KaliAssistant/Lichee-Jack-pcb/doc/3D-BTM.png

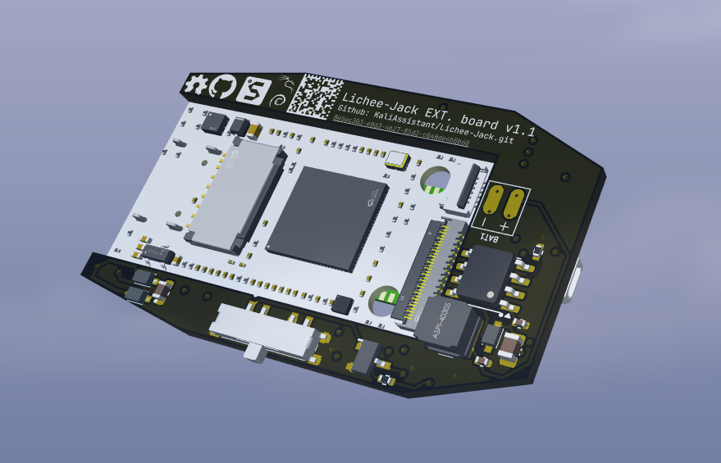
doc/3D-BTM.png
