KaliAssistant/Lichee-Jack-pcb/doc/3D-TOP.png

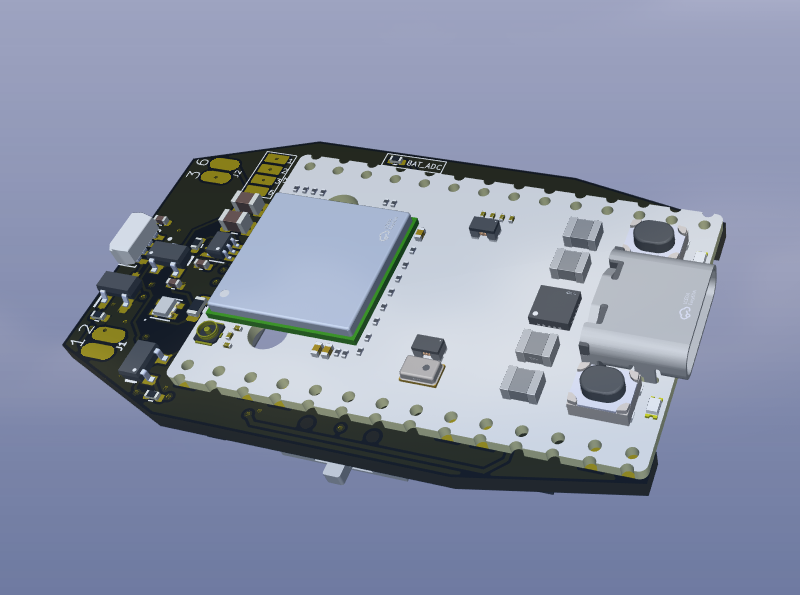
doc/3D-TOP.png
