KaliAssistant/Lichee-Jack-pcb/doc/FPC.jpg

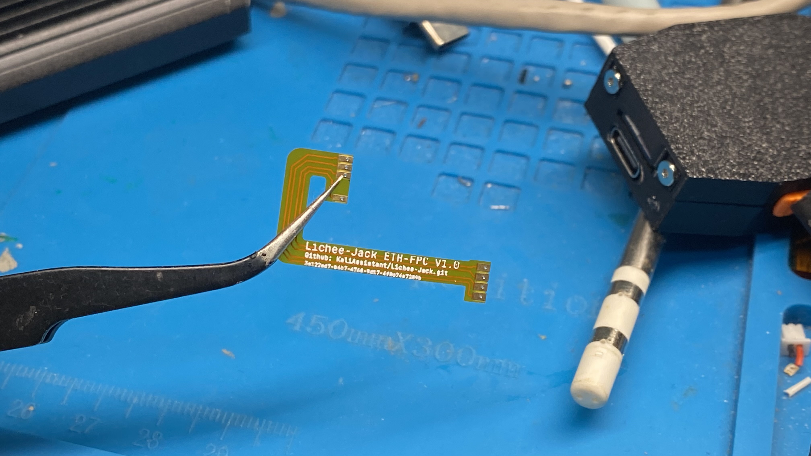
doc/FPC.jpg
