KaliAssistant/Lichee-Jack-pcb/doc/FPC_EDA.png

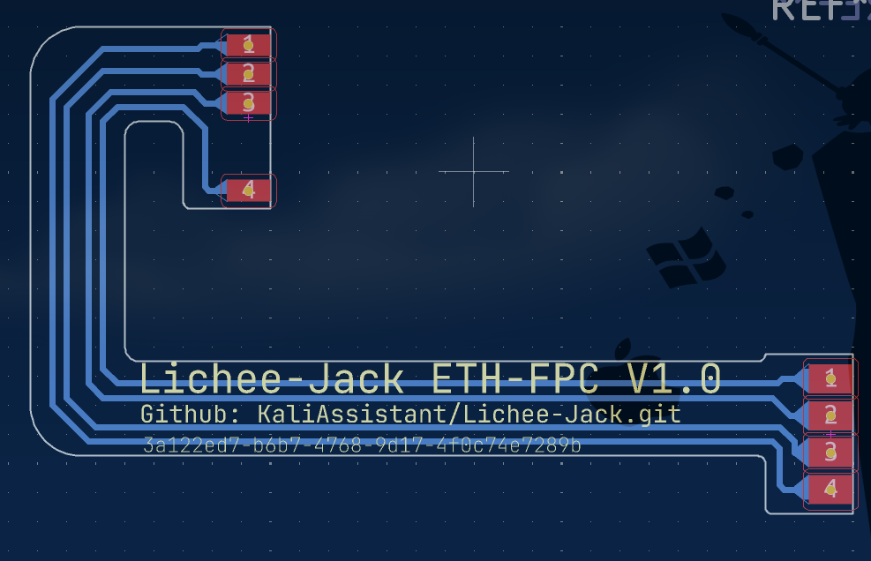
doc/FPC_EDA.png
