KaliAssistant/Lichee-Jack-pcb/doc/stackforfpcboard-3dview.png

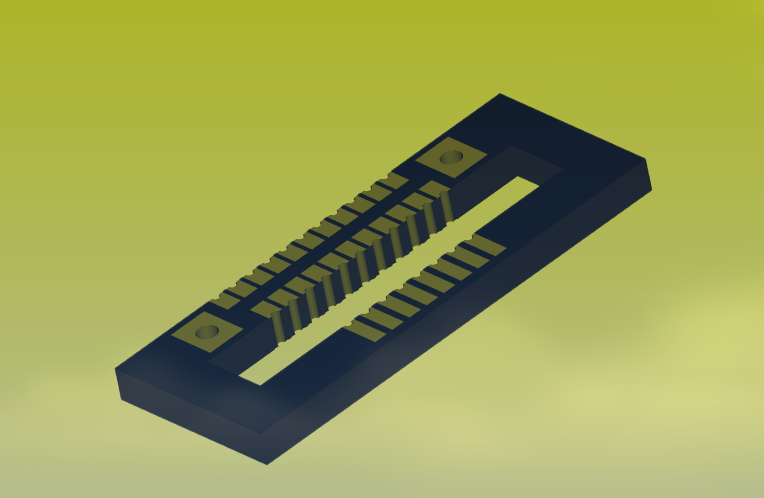
doc/stackforfpcboard-3dview.png
