KaliAssistant/Lichee-Jack-pcb/doc/stackforfpcboard-freecad.png

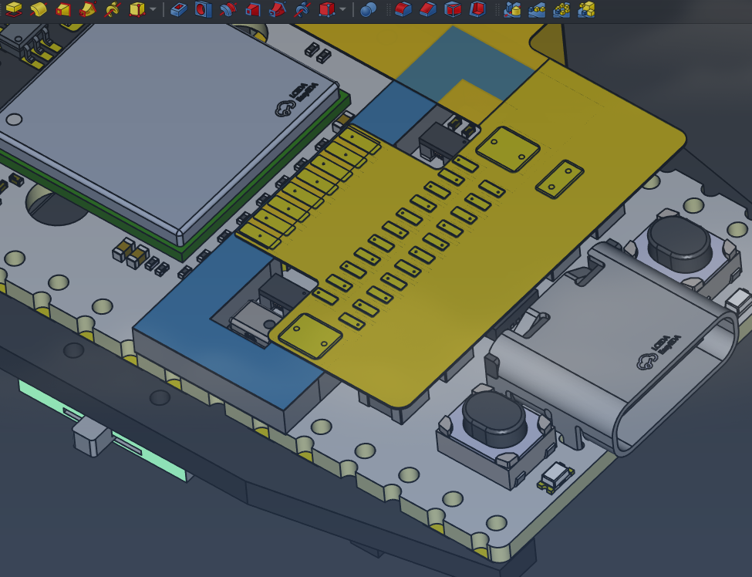
doc/stackforfpcboard-freecad.png
