KaliAssistant/Lichee-Jack-pcb/3dmodules/LED0603-RD-1.step

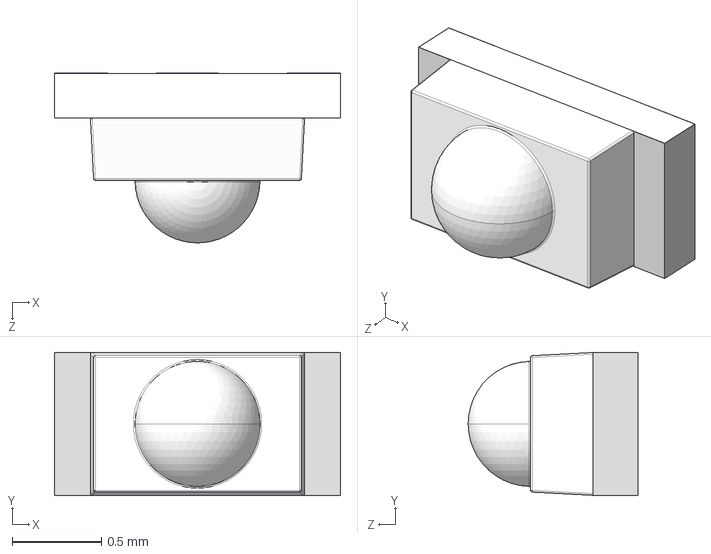
[picture p22: CAD file, 2026-01-12]
3dmodules/LED0603-RD-1.step
1.60 x 0.801 x 0.951 mm
