KaliAssistant/Lichee-Jack-pcb/3dmodules/SOT-23-5_L3.0-W1.6-P0.95-LS2.8-BR.step

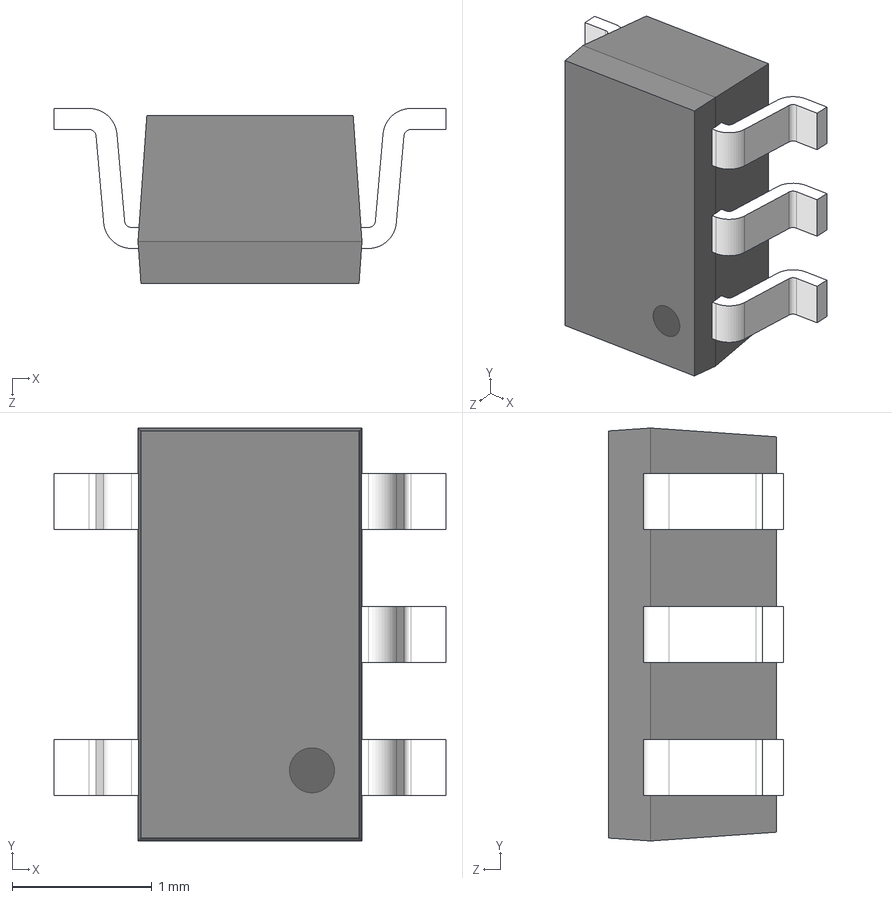
[picture p23: CAD file, 2026-01-11]
3dmodules/SOT-23-5_L3.0-W1.6-P0.95-LS2.8-BR.step
2.80 x 2.95 x 1.25 mm
