KaliAssistant/Lichee-Jack-pcb/3dmodules/LED0603_Inf.step

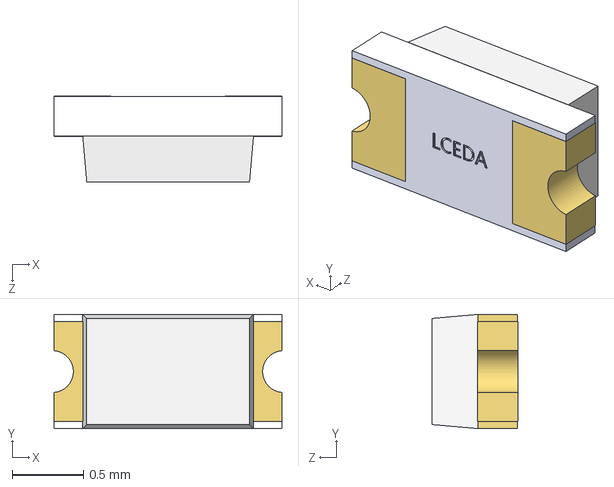
[picture p24: CAD file, 2026-01-11]
3dmodules/LED0603_Inf.step
1.60 x 0.802 x 0.601 mm
