KaliAssistant/Lichee-Jack-pcb/3dmodules/USB-C_SMD-TYPE-C-31-M-12.step

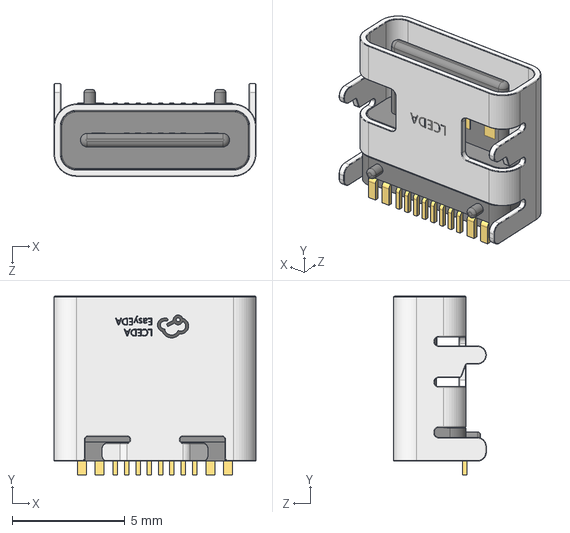
[picture p25: CAD file, 2026-01-11]
3dmodules/USB-C_SMD-TYPE-C-31-M-12.step
8.94 x 7.90 x 4.10 mm
