KaliAssistant/Lichee-Jack-pcb/3dmodules/LED0603-RD_GREEN.step

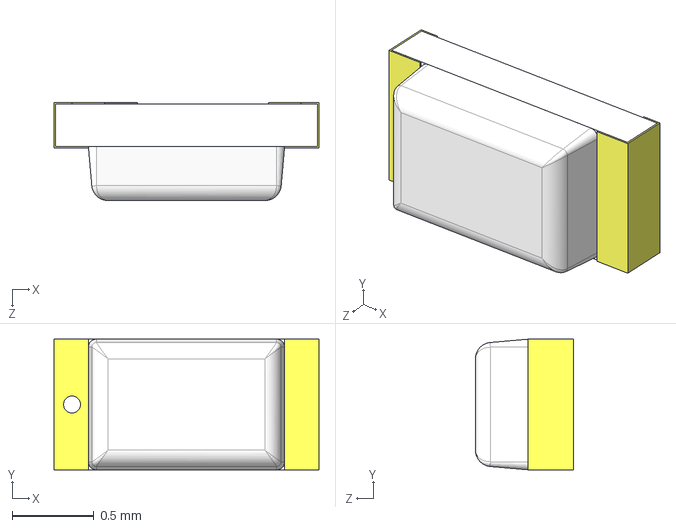
[picture p26: CAD file, 2026-01-11]
3dmodules/LED0603-RD_GREEN.step
1.62 x 0.8 x 0.6 mm
