KaliAssistant/Lichee-Jack-pcb/3dmodules/WQFN-28_L5.0-W5.0-P0.50-BL-EP3.2.step

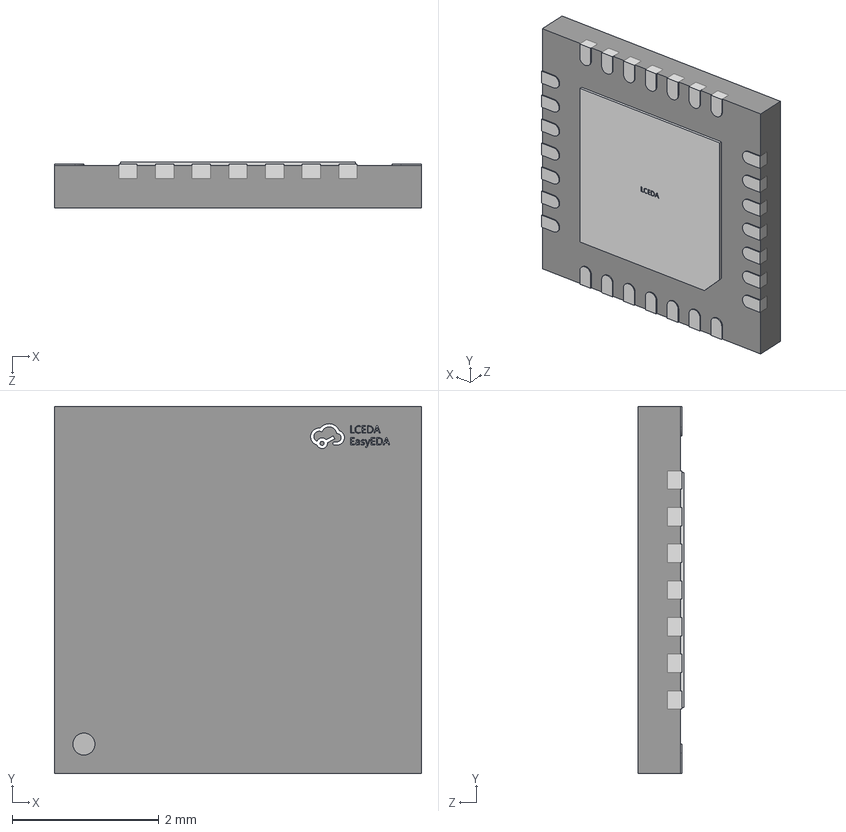
[picture p27: CAD file, 2026-01-11]
3dmodules/WQFN-28_L5.0-W5.0-P0.50-BL-EP3.2.step
5.00 x 5.00 x 0.631 mm
