KaliAssistant/Lichee-Jack-pcb/3dmodules/C1210_L3.2-W2.5-H2.5.step

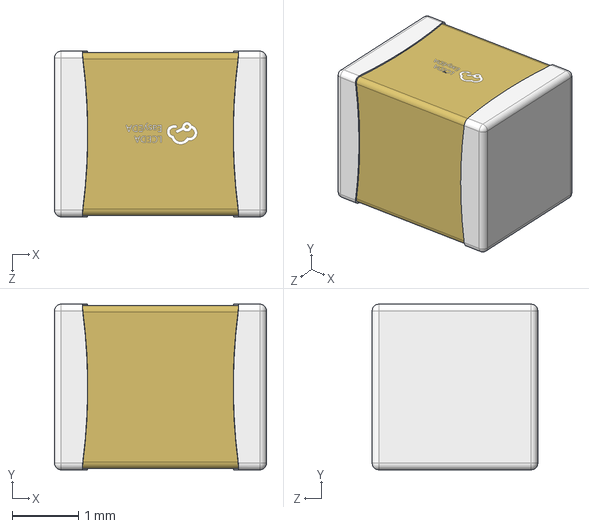
[picture p28: CAD file, 2026-01-11]
3dmodules/C1210_L3.2-W2.5-H2.5.step
3.20 x 2.50 x 2.50 mm
