KaliAssistant/Lichee-Jack-pcb/3dmodules/CRYSTAL-SMD_4P-L2.0-W1.6-BL.step

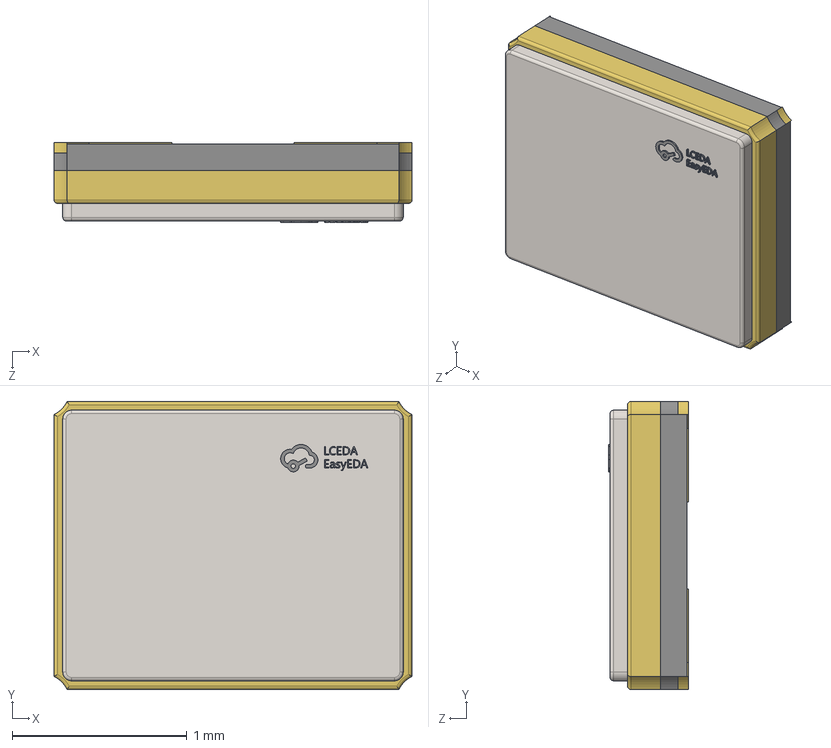
[picture p29: CAD file, 2026-01-11]
3dmodules/CRYSTAL-SMD_4P-L2.0-W1.6-BL.step
2.05 x 1.65 x 0.46 mm
