KaliAssistant/Lichee-Jack-pcb/3dmodules/X1SON-2_L1.0-W0.6-H0.4-P0.65.step

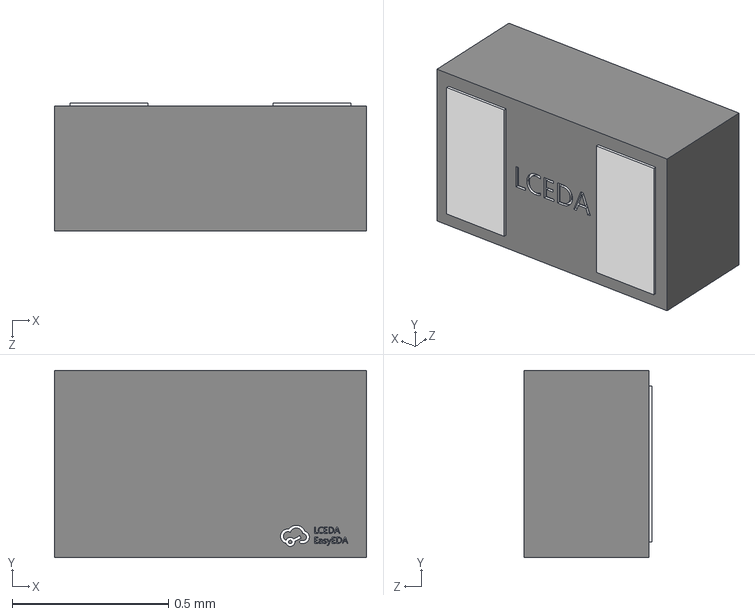
[picture p30: CAD file, 2026-01-11]
3dmodules/X1SON-2_L1.0-W0.6-H0.4-P0.65.step
1.00 x 0.6 x 0.411 mm
