KaliAssistant/Lichee-Jack-pcb/3dmodules/QFN-24_L4.0-W4.0-H0.9-P0.50.step

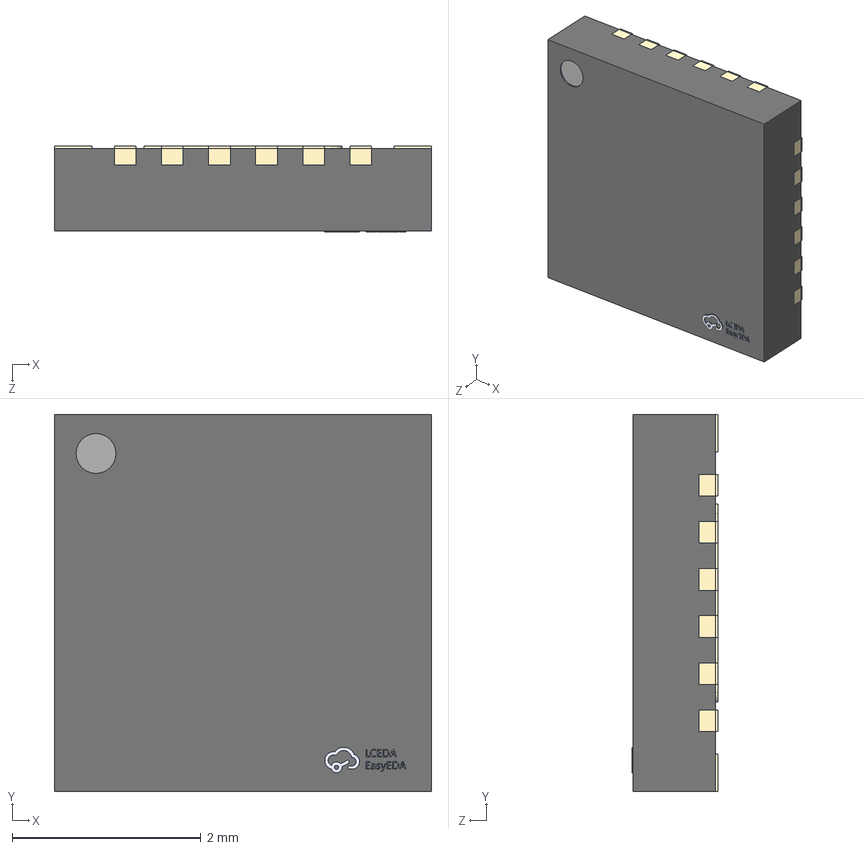
[picture p31: CAD file, 2026-01-11]
3dmodules/QFN-24_L4.0-W4.0-H0.9-P0.50.step
4.00 x 4.00 x 0.91 mm
