KaliAssistant/Lichee-Jack-pcb/3dmodules/wio-sx1262-N-no-shield.step

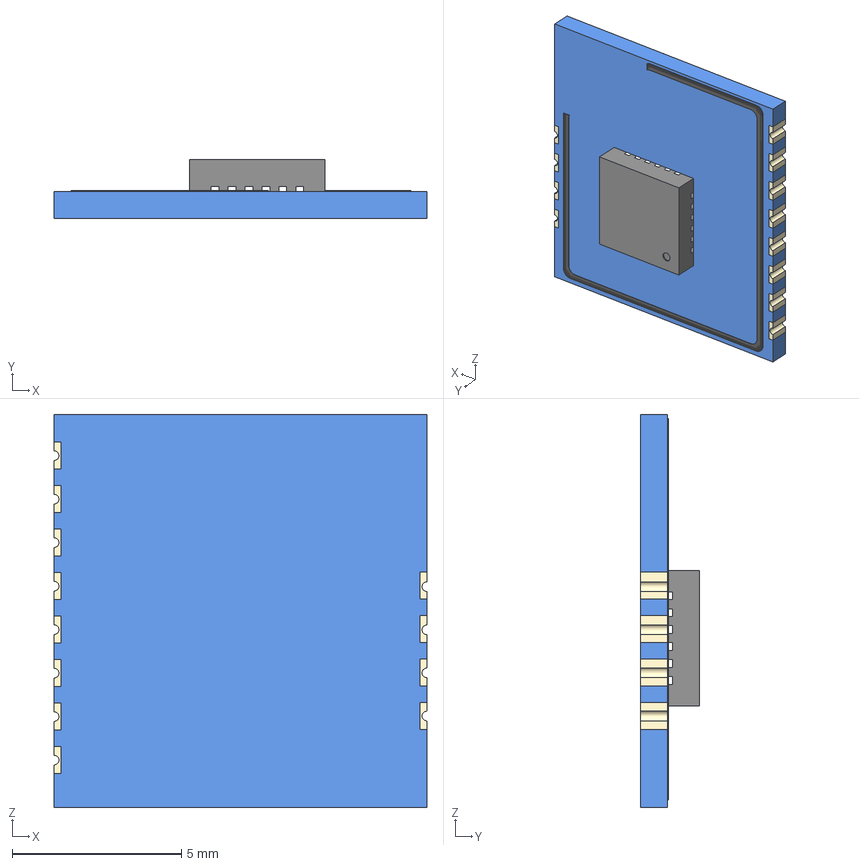
[picture p32: CAD file, 2025-12-26]
3dmodules/wio-sx1262-N-no-shield.step
11.0 x 1.75 x 11.6 mm
STM32F413CHU6
STM32F413CHU007
STM32F413CHU008
STM32F413CHU009
STM32F413CHU010
STM32F413CHU011
STM32F413CHU012
STM32F413CHU013
STM32F413CHU014
STM32F413CHU015
STM32F413CHU016
STM32F413CHU017
STM32F413CHU018
STM32F413CHU019
STM32F413CHU020
STM32F413CHU021
STM32F413CHU022
STM32F413CHU023
STM32F413CHU024
STM32F413CHU025
STM32F413CHU026
STM32F413CHU027
STM32F413CHU028
STM32F413CHU029
STM32F413CHU030
STM32F413CHU031
Mesh_Mesh_head_geo.001_lambert2SG.001
