KaliAssistant/Lichee-Jack-pcb/3dmodules/USB-A-TH_USB-05.step

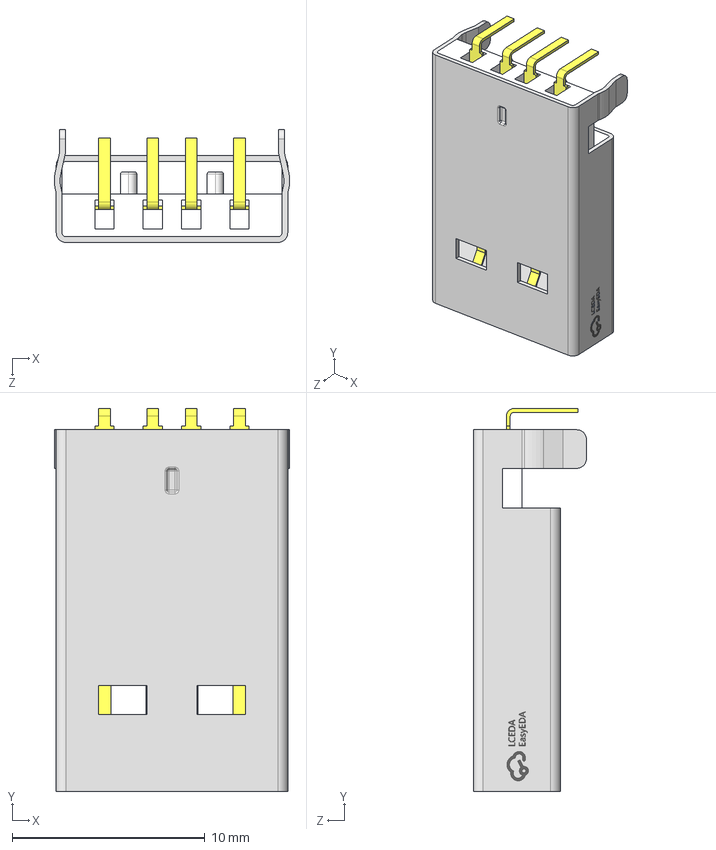
[picture p33: CAD file, 2025-12-26]
3dmodules/USB-A-TH_USB-05.step
12.2 x 19.9 x 5.85 mm
