KaliAssistant/Lichee-Jack-pcb/3dmodules/FFC-SMD_8P-P0.50_F0504-H-08-10G-R.step

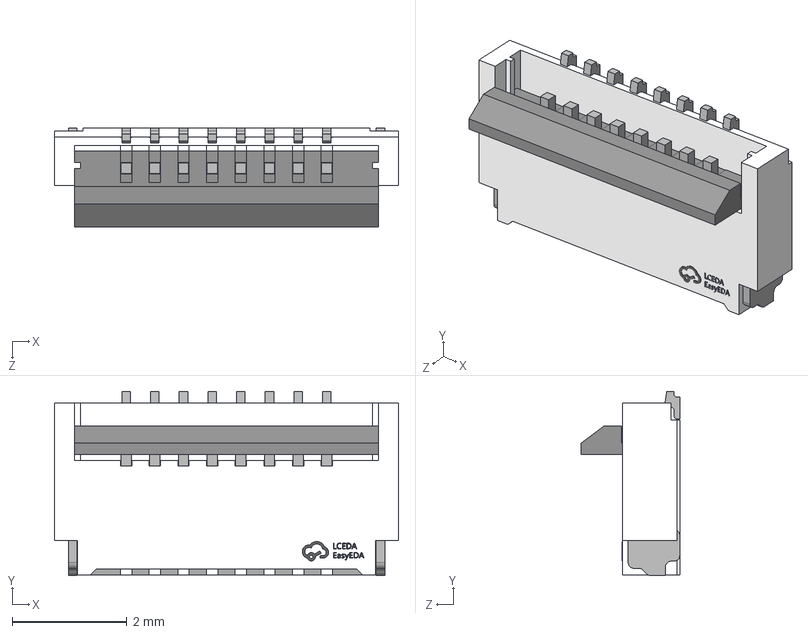
[picture p34: CAD file, 2025-12-26]
3dmodules/FFC-SMD_8P-P0.50_F0504-H-08-10G-R.step
6.00 x 3.21 x 1.72 mm
