KaliAssistant/Lichee-Jack-pcb/3dmodules/ABM8G-24.000MHZ-18-D2Y-T.step

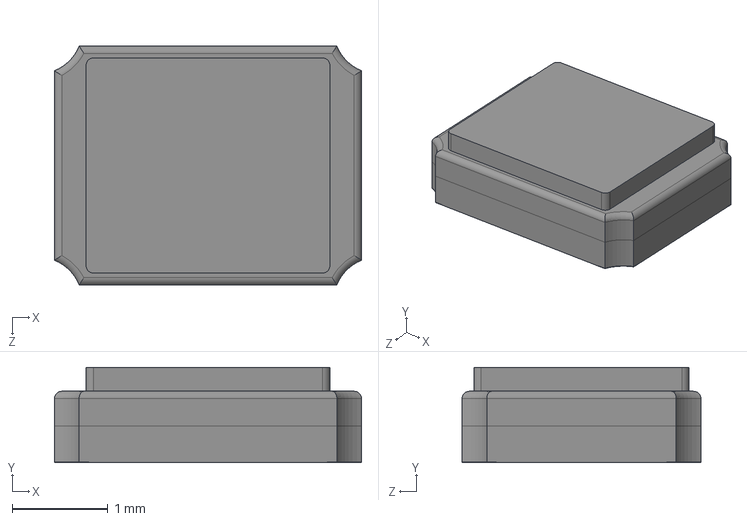
[picture p35: CAD file, 2025-12-26]
3dmodules/ABM8G-24.000MHZ-18-D2Y-T.step
3.20 x 0.991 x 2.49 mm
