KaliAssistant/Lichee-Jack-pcb/3dmodules/LICHEE-JACK_HEADER_BOARD.step

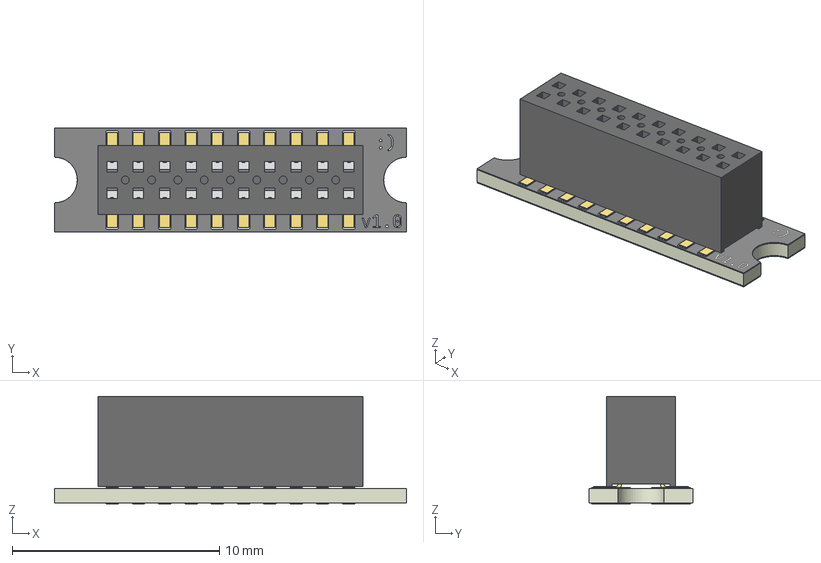
[picture p36: CAD file, 2025-12-26]
3dmodules/LICHEE-JACK_HEADER_BOARD.step
17.0 x 5.00 x 5.24 mm
FLE-110-01-DV_socket
C-96-01-10-DV
LICHEE-JACK_HEADER_BOARD_pad
LICHEE-JACK_HEADER_BOARD_silkscreen x 2
LICHEE-JACK_HEADER_BOARD_soldermask x 2
LICHEE-JACK_HEADER_BOARD_PCB
