KaliAssistant/Lichee-Jack-pcb/3dmodules/USB-C-SMD_C561769.step

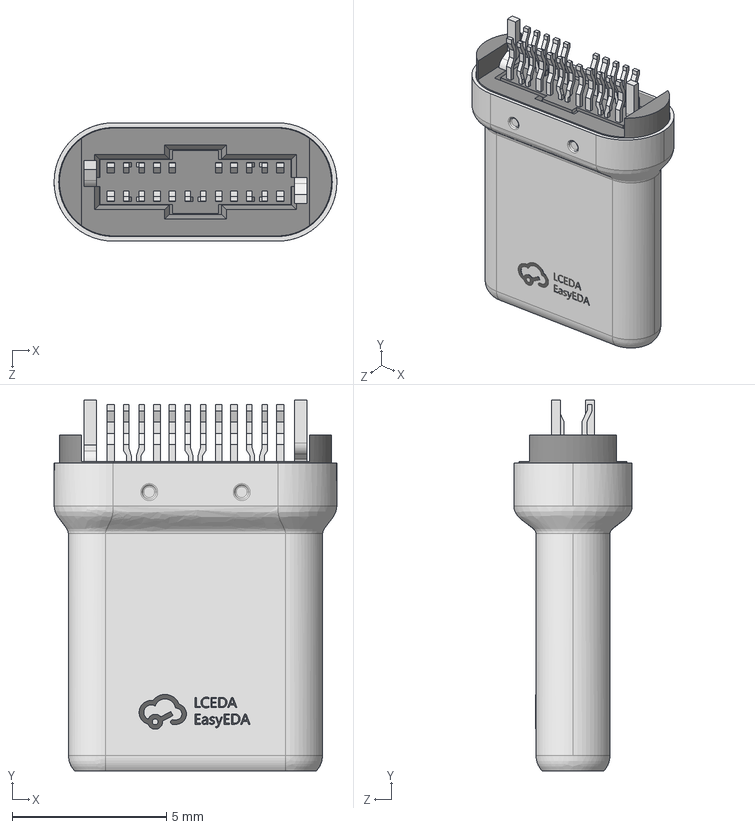
[picture p37: CAD file, 2025-12-26]
3dmodules/USB-C-SMD_C561769.step
9.18 x 12.0 x 3.84 mm
