KaliAssistant/Lichee-Jack-pcb/3dmodules/NFP114H_TFTLCD.step

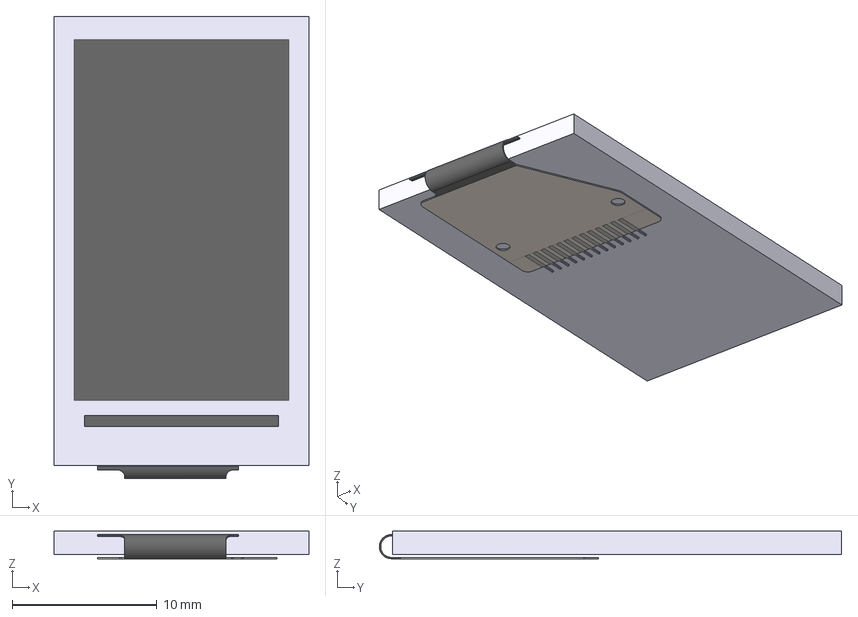
[picture p38: CAD file, 2025-12-26]
3dmodules/NFP114H_TFTLCD.step
17.6 x 31.9 x 1.90 mm
