KaliAssistant/Lichee-Jack-pcb/3dmodules/FLE-110-01-G-DV-K-TR.step

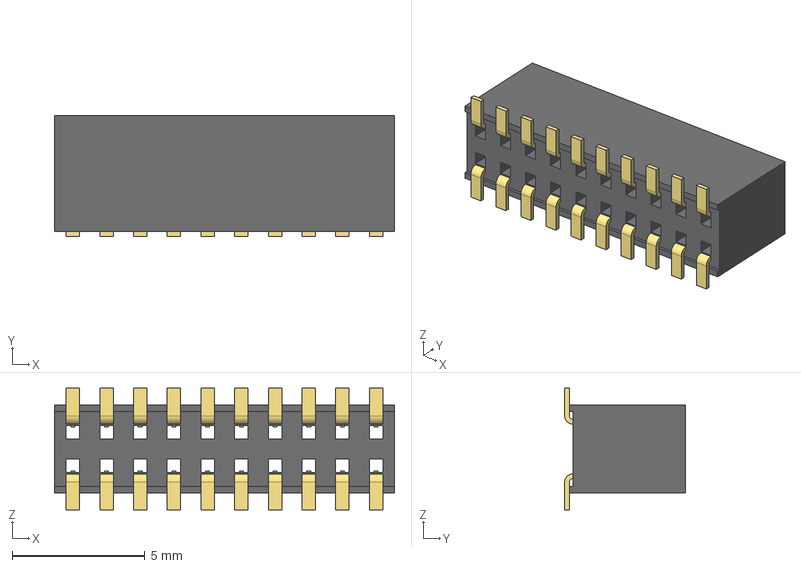
[picture p39: CAD file, 2025-12-26]
3dmodules/FLE-110-01-G-DV-K-TR.step
12.8 x 4.55 x 4.59 mm
FLE-110-01-DV_socket
C-96-01-10-DV
