KaliAssistant/Lichee-Jack-pcb/3dmodules/FFC-SMD_6P-P0.50_F0504-H-06-10G-R.step

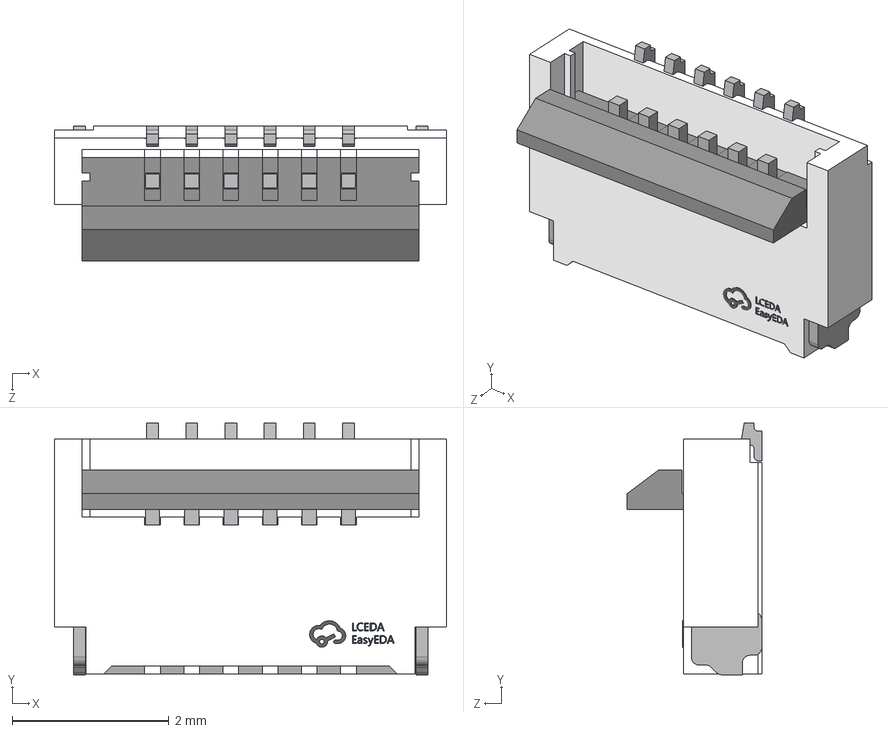
[picture p40: CAD file, 2025-12-26]
3dmodules/FFC-SMD_6P-P0.50_F0504-H-06-10G-R.step
5.00 x 3.21 x 1.72 mm
