KaliAssistant/Lichee-Jack-pcb/3dmodules/SW-SMD_4P-L3.0-W2.8-H1.4-P1.65-TL.step

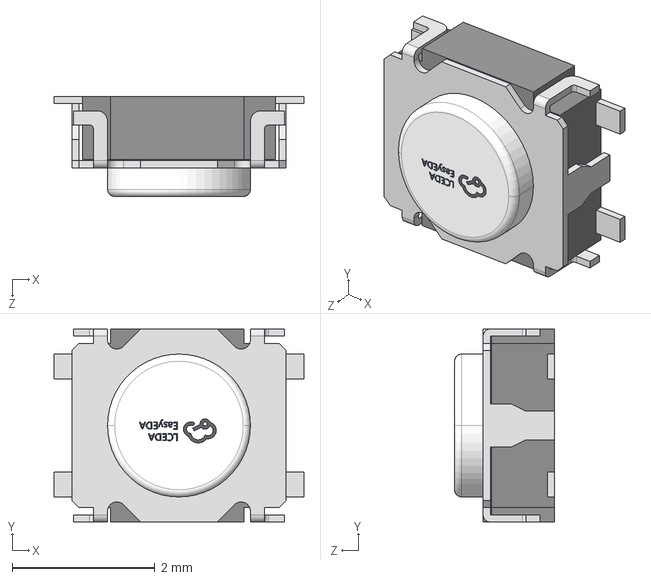
[picture p42: CAD file, 2025-12-26]
3dmodules/SW-SMD_4P-L3.0-W2.8-H1.4-P1.65-TL.step
3.50 x 2.70 x 1.40 mm
