KaliAssistant/Lichee-Jack-pcb/3dmodules/FTS-110-04-F-D.step

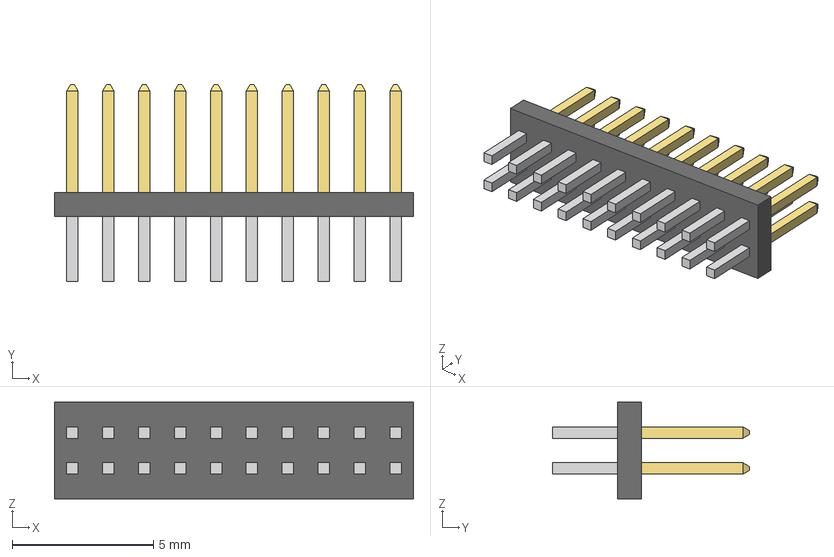
[picture p43: CAD file, 2025-12-26]
3dmodules/FTS-110-04-F-D.step
12.7 x 6.96 x 3.43 mm
FTS-110-04-F-D_body
FTS-110-04-F-D_pins1
FTS-110-04-F-D_pins2
