KaliAssistant/Lichee-Jack-pcb/3dmodules/USB-C-SMD_TYPE-C-24P-GTJB-040.step

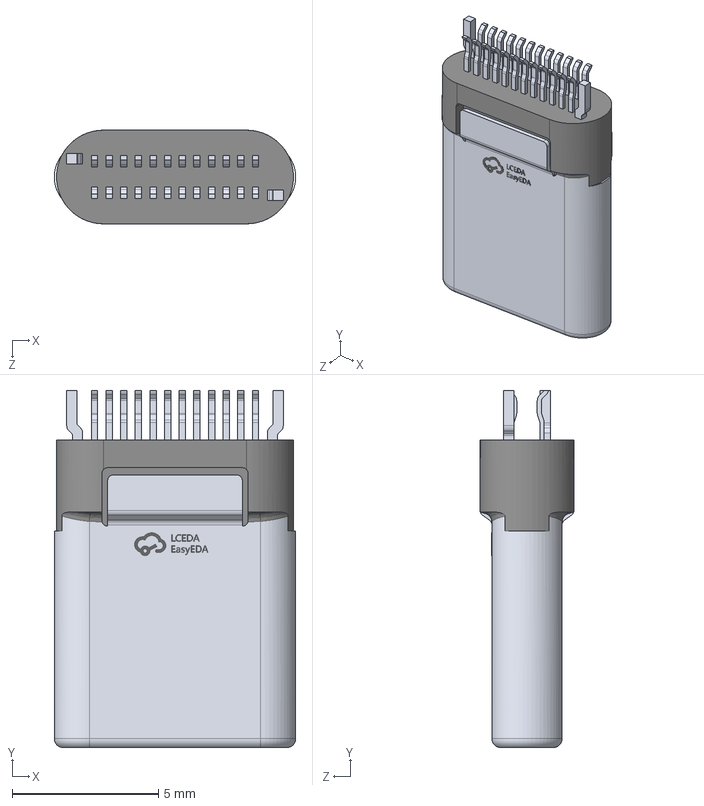
[picture p44: CAD file, 2025-12-26]
3dmodules/USB-C-SMD_TYPE-C-24P-GTJB-040.step
8.25 x 12.2 x 3.20 mm
