KaliAssistant/Lichee-Jack-pcb/3dmodules/CLP-110-02-F-D.step

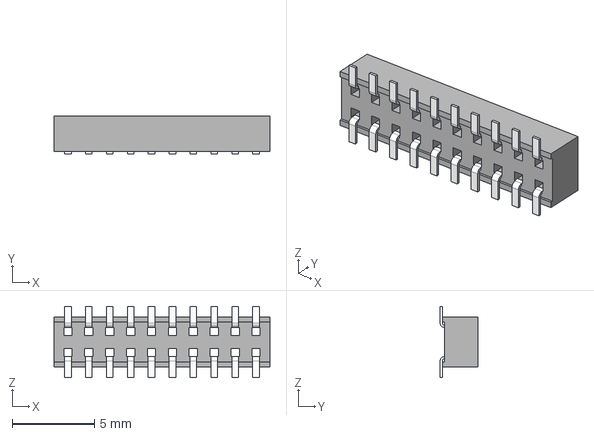
[picture p45: CAD file, 2025-12-26]
3dmodules/CLP-110-02-F-D.step
13.1 x 2.29 x 4.32 mm
CLP-110-2-F-DTRM
C-106-22-1-F-10_Pin x 2
