KaliAssistant/Lichee-Jack-pcb/3dmodules/FTSH-110-X-X-DV.step

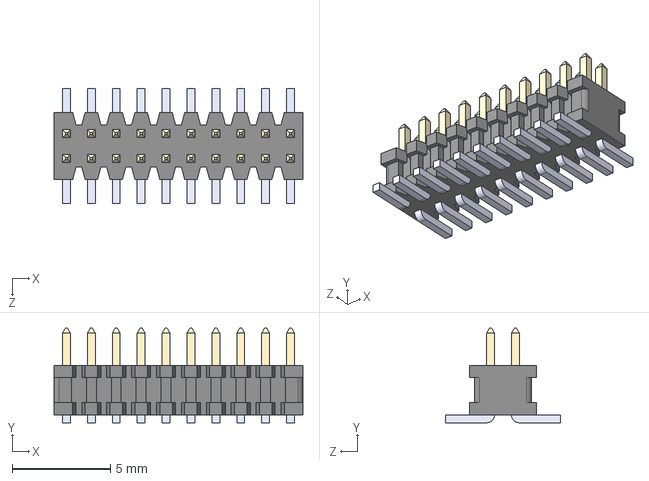
[picture p46: CAD file, 2025-12-26]
3dmodules/FTSH-110-X-X-DV.step
12.7 x 4.83 x 5.84 mm
