KaliAssistant/Lichee-Jack-pcb/3dmodules/CAT24C128WI-GT3.step

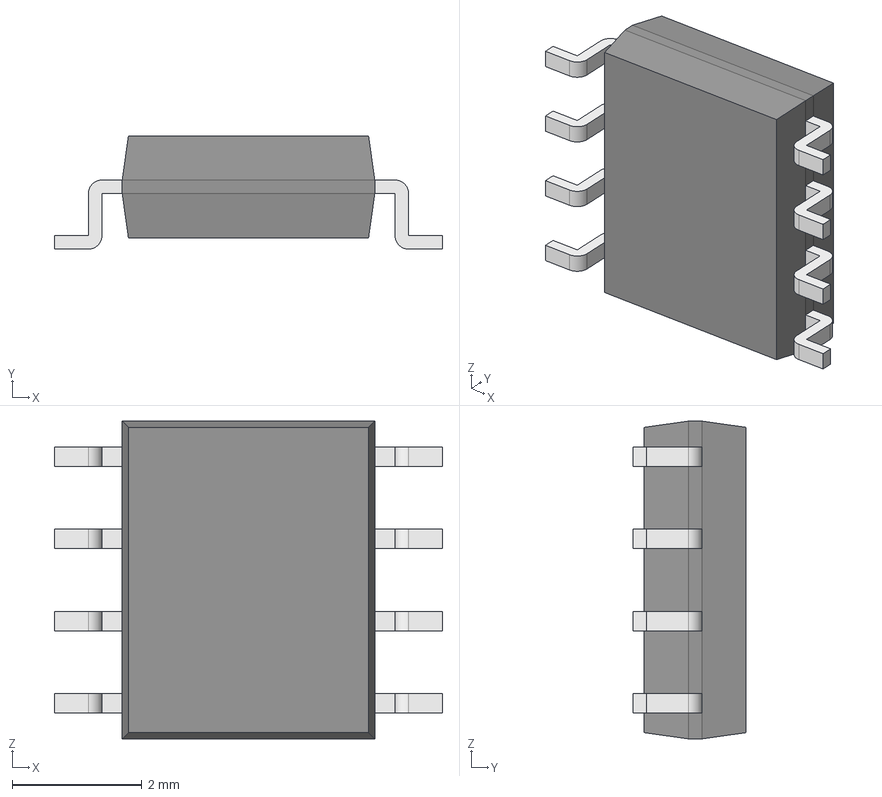
[picture p47: CAD file, 2025-12-26]
3dmodules/CAT24C128WI-GT3.step
5.99 x 1.75 x 4.91 mm
Body001 (Mirror #1) x 4
XY-plane x 12
X-axis x 12
