KaliAssistant/Lichee-Jack-pcb/3dmodules/CX70M-24P1.step

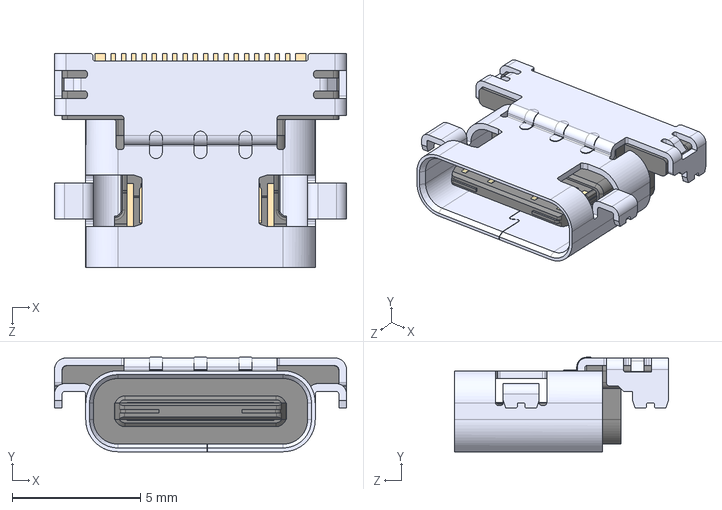
[picture p48: CAD file, 2025-12-26]
3dmodules/CX70M-24P1.step
11.4 x 3.69 x 8.35 mm
