KaliAssistant/Lichee-Jack-pcb/3dmodules/wio-sx1262.step

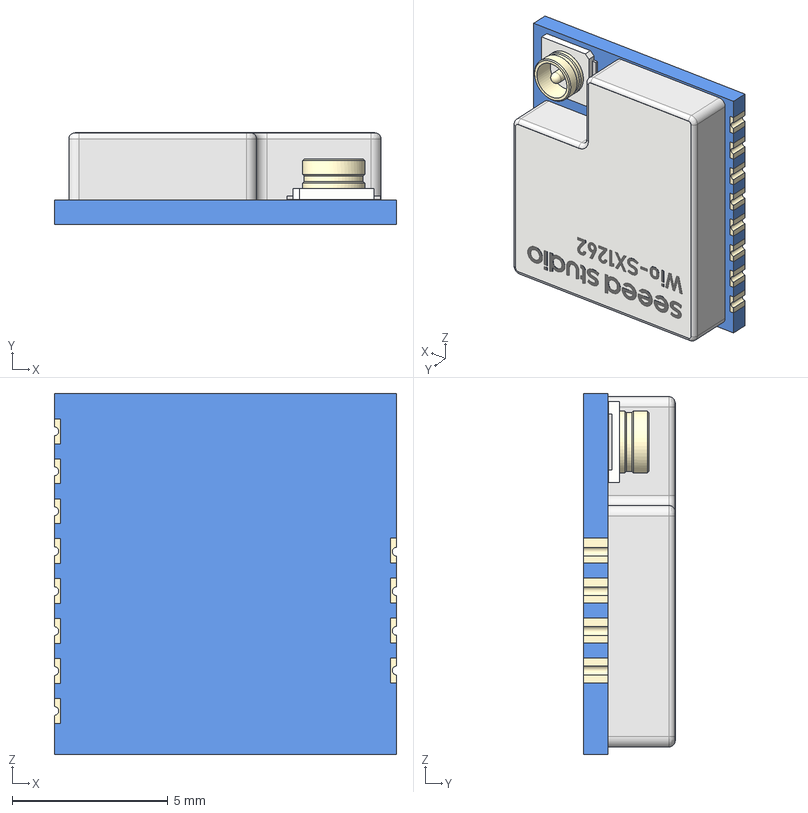
[picture p49: CAD file, 2025-12-26]
3dmodules/wio-sx1262.step
11.0 x 2.97 x 11.6 mm
