KaliAssistant/Lichee-Jack-pcb/3dmodules/JST-1.25.step

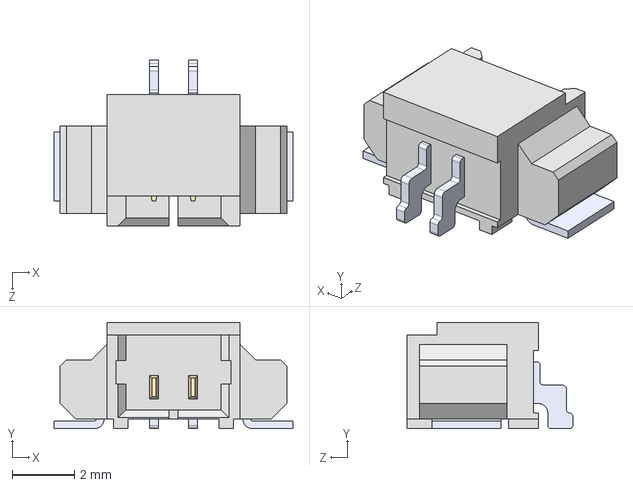
[picture p50: CAD file, 2025-09-16]
3dmodules/JST-1.25.step
7.65 x 3.40 x 5.30 mm
