KaliAssistant/Lichee-Jack-pcb/3dmodules/LED_RGB_0603.step

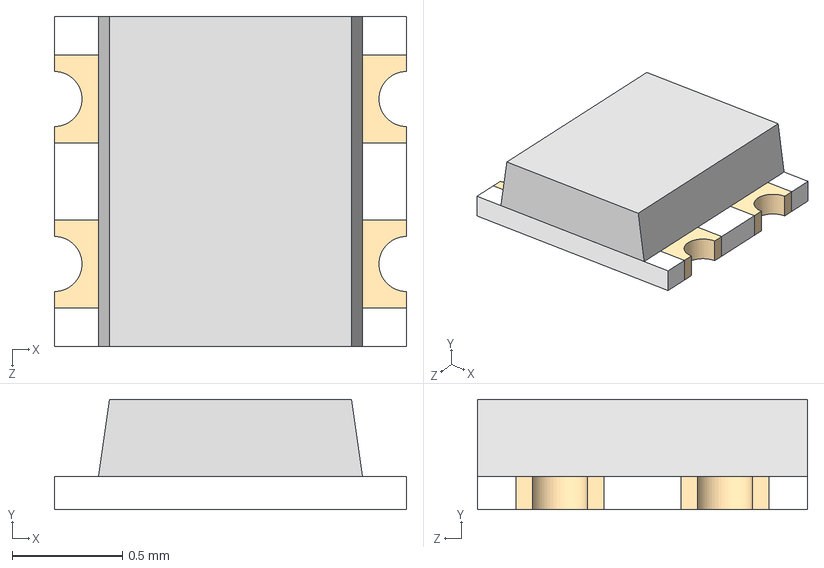
[picture p51: CAD file, 2025-09-16]
3dmodules/LED_RGB_0603.step
1.60 x 0.5 x 1.50 mm
