KaliAssistant/Lichee-Jack-pcb/3dmodules/ASPI-4030S-XXXM-T.step

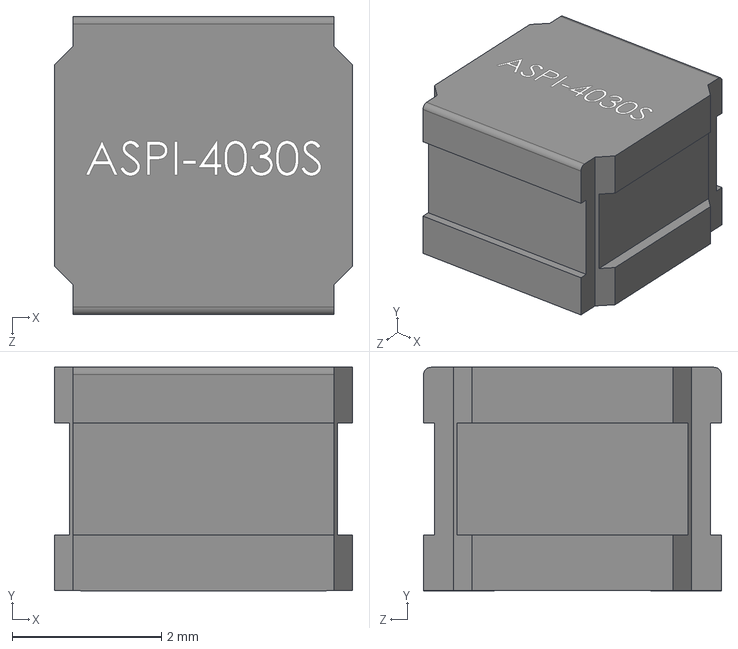
[picture p52: CAD file, 2025-09-16]
3dmodules/ASPI-4030S-XXXM-T.step
4.00 x 3.00 x 4.00 mm
