KaliAssistant/Lichee-Jack-pcb/3dmodules/EG1315AA.step

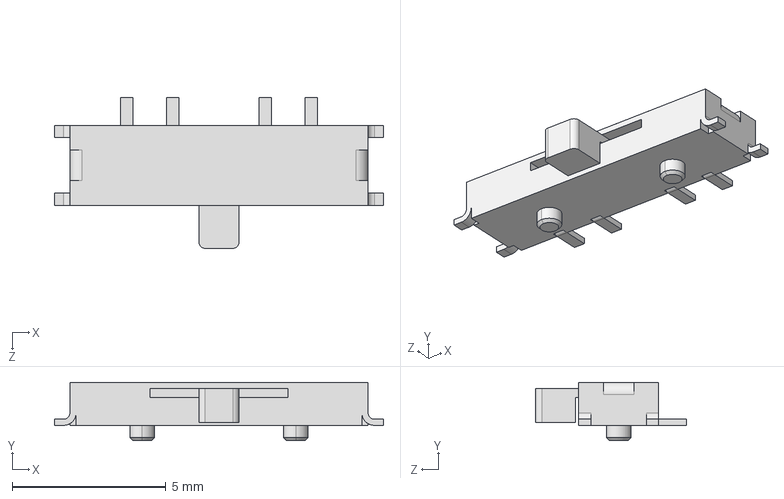
[picture p53: CAD file, 2025-09-16]
3dmodules/EG1315AA.step
10.7 x 1.90 x 4.90 mm
