KaliAssistant/Lichee-Jack-pcb/3dmodules/AO3401A.step

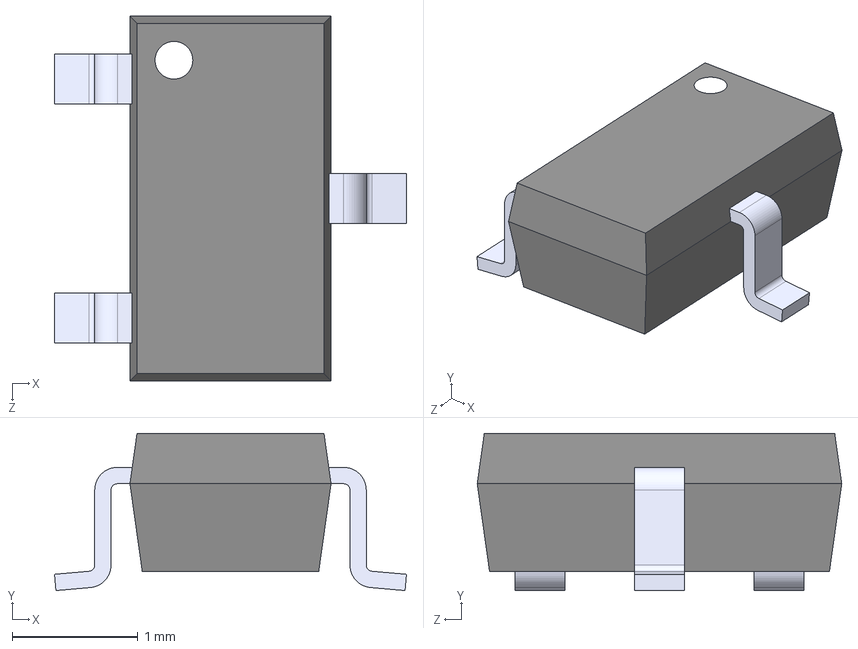
[picture p54: CAD file, 2025-09-16]
3dmodules/AO3401A.step
2.80 x 1.25 x 2.90 mm
