KaliAssistant/Lichee-Jack-pcb/3dmodules/FS8205.step

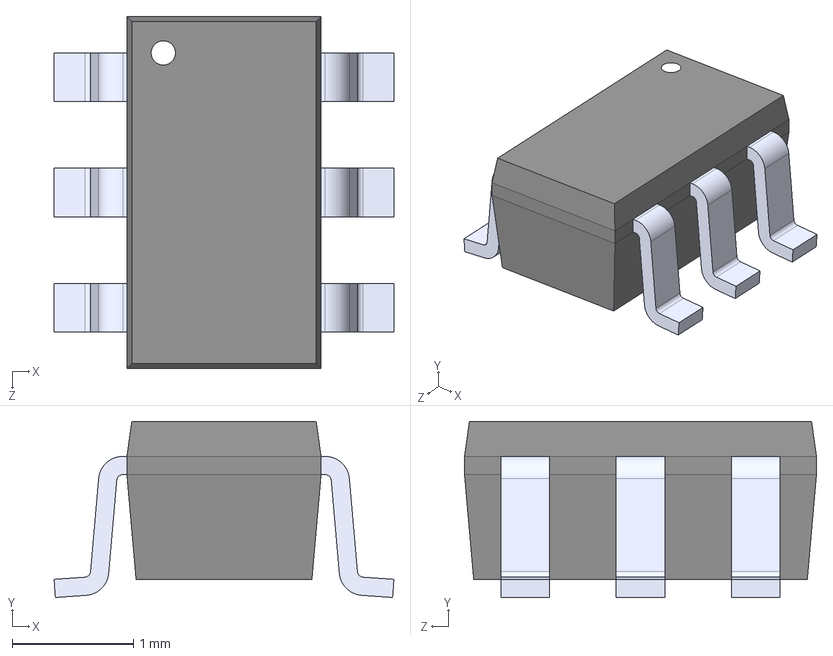
[picture p55: CAD file, 2025-09-16]
3dmodules/FS8205.step
2.80 x 1.45 x 2.90 mm
