KaliAssistant/Lichee-Jack-pcb/3dmodules/WS2812B-4020.step

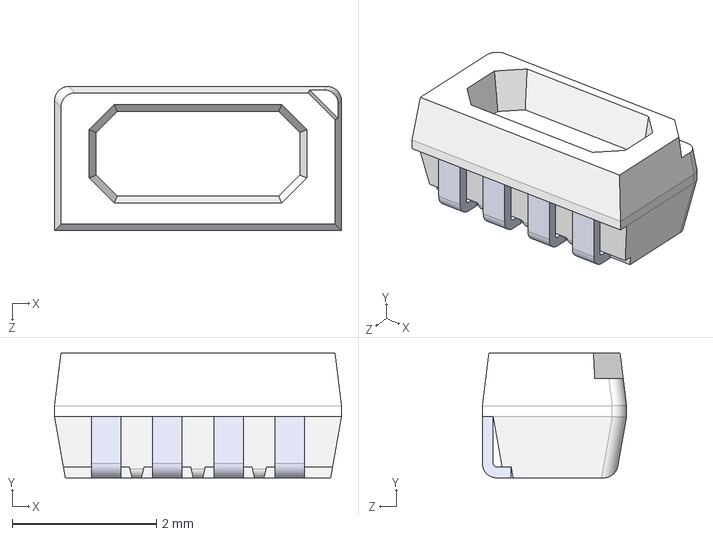
[picture p56: CAD file, 2025-09-16]
3dmodules/WS2812B-4020.step
3.98 x 1.73 x 2.00 mm
