KaliAssistant/Lichee-Jack-pcb/3dmodules/EG1215AA.step

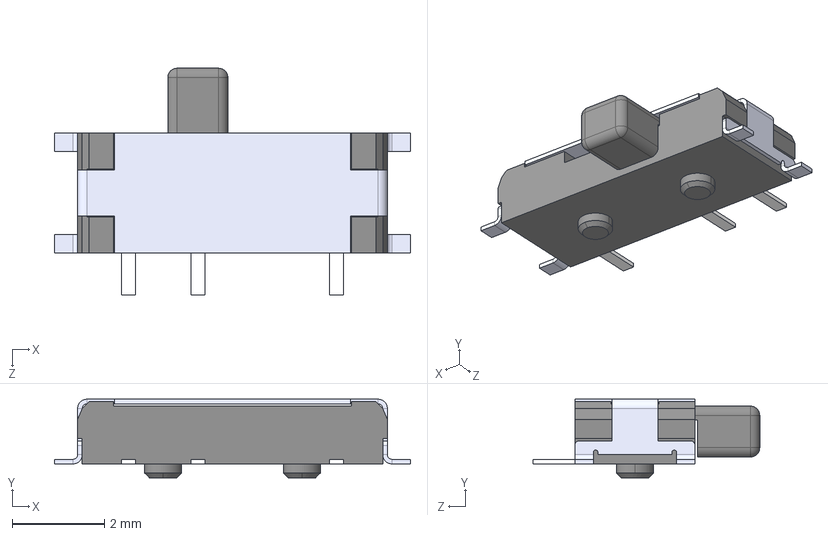
[picture p57: CAD file, 2025-09-16]
3dmodules/EG1215AA.step
7.70 x 1.70 x 4.90 mm
