KaliAssistant/Lichee-Jack-pcb/3dmodules/AO3400.step

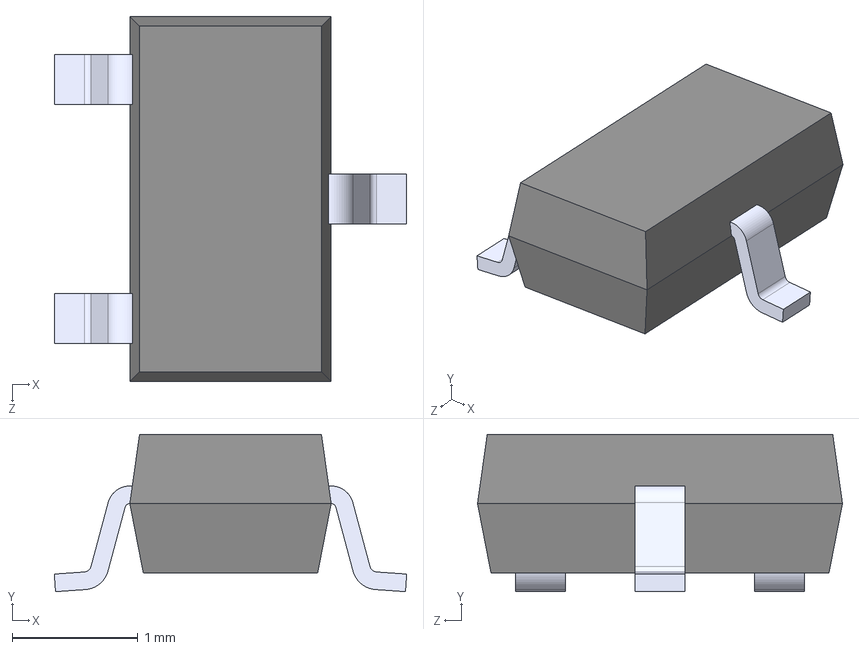
[picture p58: CAD file, 2025-09-16]
3dmodules/AO3400.step
2.80 x 1.25 x 2.90 mm
