KaliAssistant/Lichee-Jack-pcb/3dmodules/PMEG4010CEJ_115.step

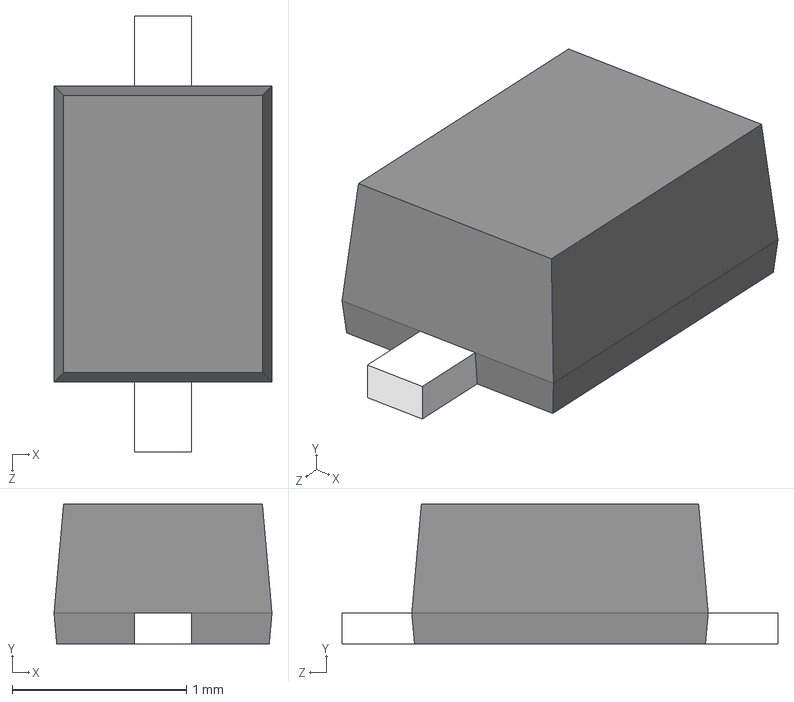
[picture p59: CAD file, 2025-09-16]
3dmodules/PMEG4010CEJ_115.step
1.25 x 0.8 x 2.50 mm
