KaliAssistant/Lichee-Jack-pcb/(list of files, cad)

Other CAD files:
3dmodules/1054440001.step
3dmodules/LM66100DCKX.step
3dmodules/TLV76733DRVR.step
