KaliAssistant/Lichee-Jack-pcb/DEBUGGER/LICHEE-JACK_USB_DEBUGGER/LICHEE-JACK_USB_DEBUGGER.kicad_pcb

## KiCad design DEBUGGER/LICHEE-JACK_USB_DEBUGGER/LICHEE-JACK_USB_DEBUGGER.kicad_pcb (2026-01-17)

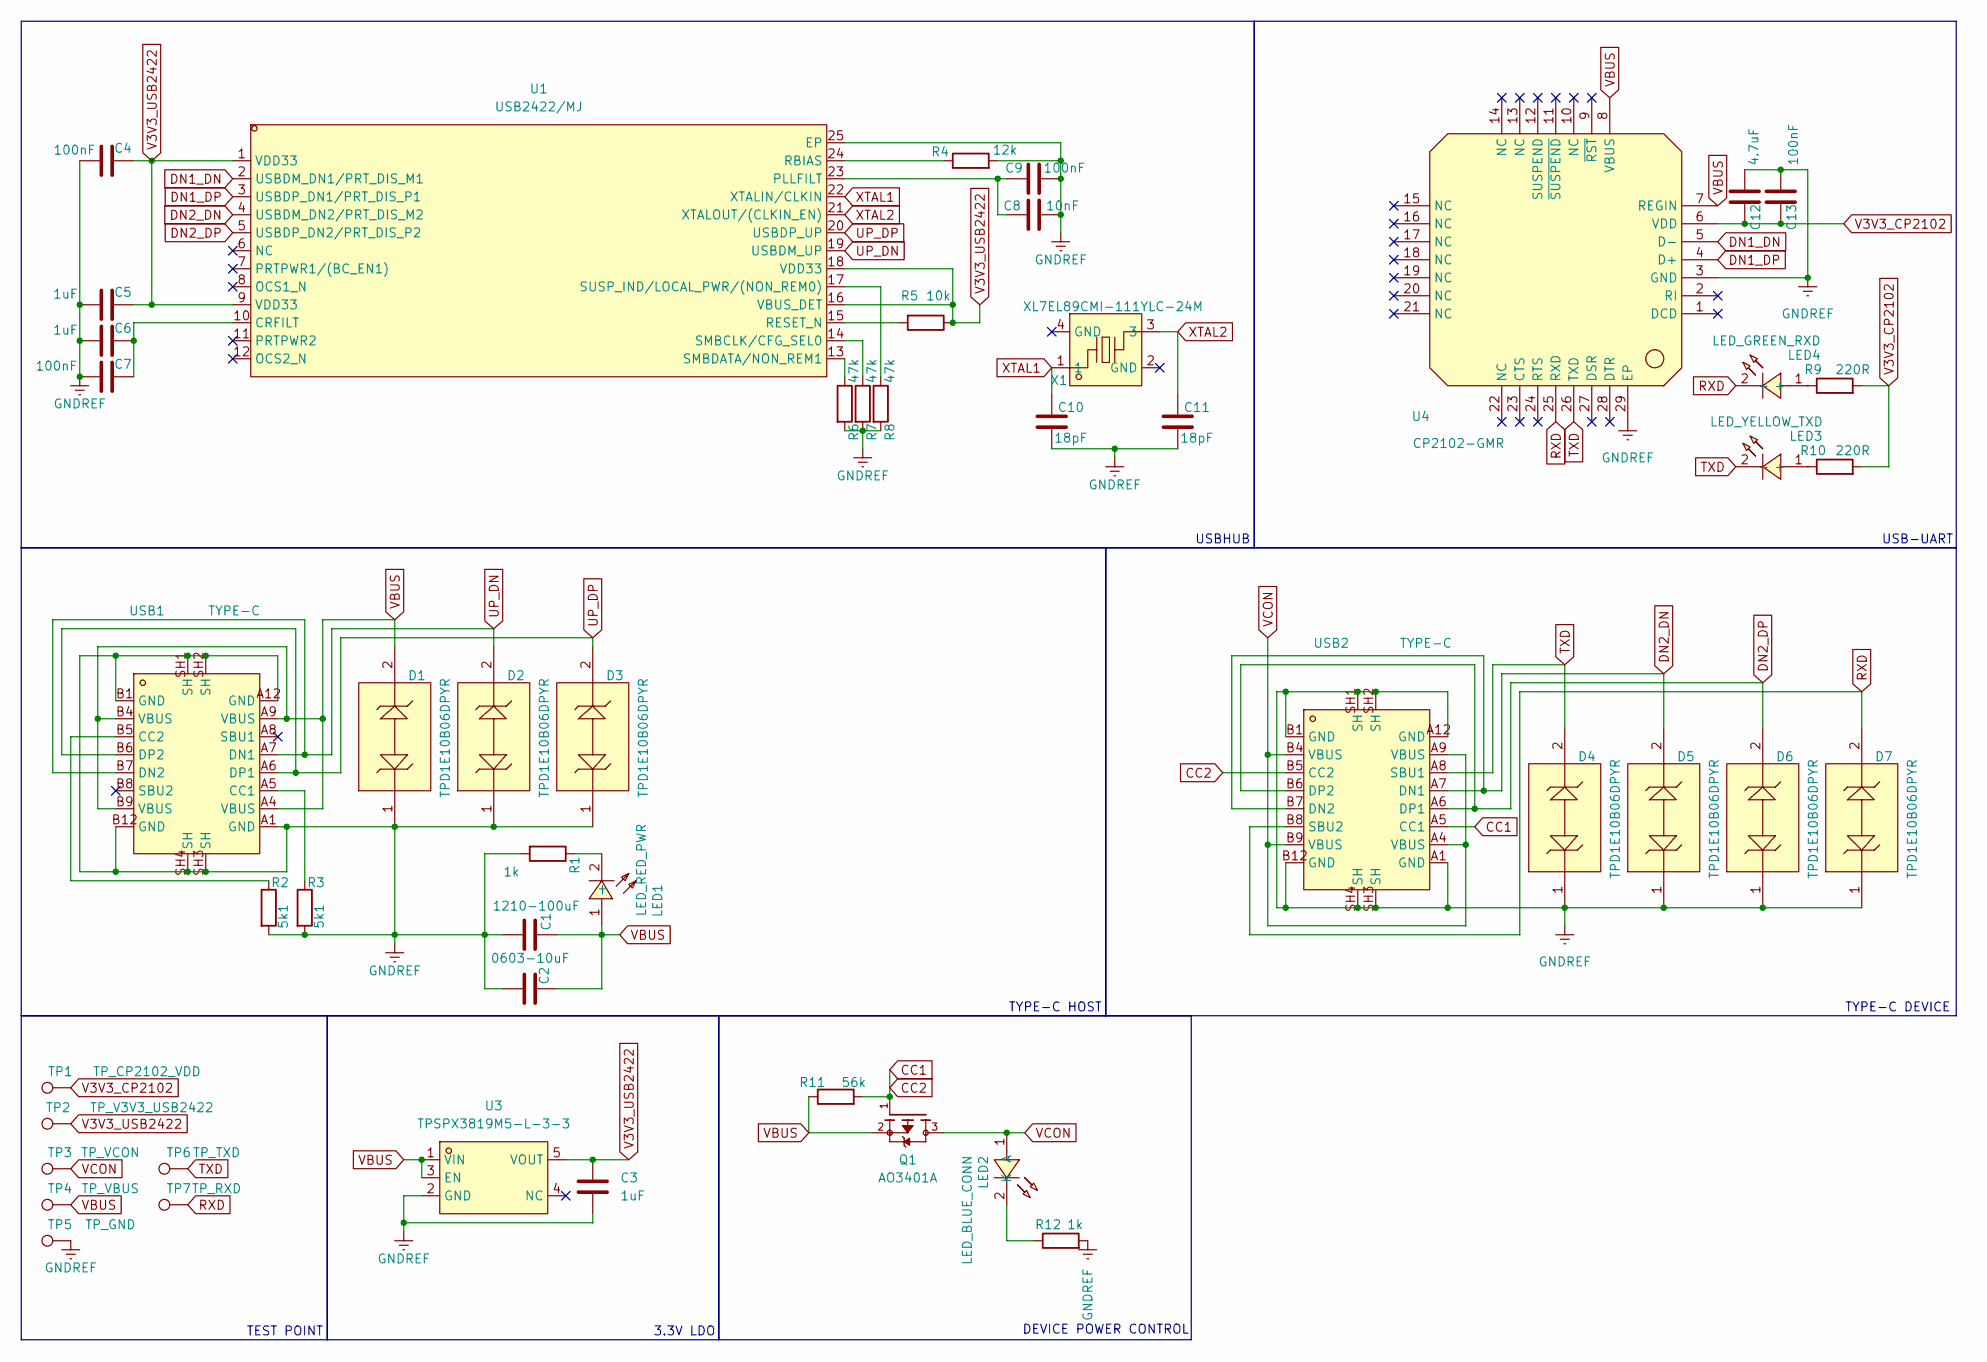
[picture p60: schematic LICHEE-JACK_USB_DEBUGGER.kicad_sch, Lichee-Jack USB Debugger]

Parts:
C1: 1210-100uF; C_1210_3225Metric
C2: 0603-10uF; C_0603_1608Metric
C3, C5, C6: 1uF; C_0402_1005Metric
C4, C7, C9, C13: 100nF; C_0402_1005Metric
C8: 10nF; C_0402_1005Metric
C10, C11: 18pF; C_0402_1005Metric
C12: 4.7uF; C_0402_1005Metric
D1, D2, D3, D4, D5, D6, D7: TPD1E10B06DPYR; X1SON-2_L1.0-W0.6-P0.65-BI; LCSC Part C48260
LED1: LED_RED_PWR; LED0603-FD; LCSC Part C19171390
LED2: LED_BLUE_CONN; LED0603-FD; LCSC Part C19171394
LED3: LED_YELLOW_TXD; LED0603-FD; LCSC Part C19273151
LED4: LED_GREEN_RXD; LED0603-FD; LCSC Part C19273151
Q1: AO3401A; SOT23-3
R1, R12: 1k; R_0402_1005Metric
R2, R3: 5k1; R_0402_1005Metric
R4: 12k; R_0402_1005Metric
R5: 10k; R_0402_1005Metric
R6, R7, R8: 47k; R_0402_1005Metric
R9, R10: 220R; R_0402_1005Metric
R11: 56k; R_0402_1005Metric
TP1: TP_CP2102_VDD; TestPoint_Pad_D1.0mm
TP2: TP_V3V3_USB2422; TestPoint_Pad_D1.0mm
TP3: TP_VCON; TestPoint_Pad_D1.0mm
TP4: TP_VBUS; TestPoint_Pad_D1.0mm
TP5: TP_GND; TestPoint_Pad_D1.0mm
TP6: TP_TXD; TestPoint_Pad_D1.0mm
TP7: TP_RXD; TestPoint_Pad_D1.0mm
U1: USB2422/MJ; QFN-24_L4.0-W4.0-P0.50-BL-EP2.6; LCSC Part C633330
U3: TPSPX3819M5-L-3-3; SOT-23-5_L3.0-W1.6-P0.95-LS2.8-BR; LCSC Part C5370980
U4: CP2102-GMR; WQFN-28_L5.0-W5.0-P0.50-BL-EP3.2; LCSC Part C6568
USB1, USB2: TYPE-C; USB-C_SMD-TYPE-C-31-M-12; LCSC Part C2927038
X1: XL7EL89CMI-111YLC-24M; CRYSTAL-SMD_4P-L2.0-W1.6-BL; LCSC Part C2965581

Connections:
CC1: Q1.1, R11.2, USB2.A5 (CC1), USB2.B5 (CC2)
DN1_DN: U1.2 (USBDM_DN1/PRT_DIS_M1), U4.5 (D-)
DN1_DP: U1.3 (USBDP_DN1/PRT_DIS_P1), U4.4 (D+)
DN2_DN: D5.2, U1.4 (USBDM_DN2/PRT_DIS_M2), USB2.A7 (DN1), USB2.B7 (DN2)
DN2_DP: D6.2, U1.5 (USBDP_DN2/PRT_DIS_P2), USB2.A6 (DP1), USB2.B6 (DP2)
GNDREF: C1.2, C2.2, C3.2, C4.2, C5.2, C6.2, C7.2, C8.1, C9.1, C10.2, C11.2, C12.1, C13.1, D1.1, D2.1, D3.1, D4.1, D5.1, D6.1, D7.1, R1.2, R2.2, R3.2, R4.2, R6.2, R7.2, R8.2, R12.2, TP5.1, U1.25 (EP), U3.2 (GND), U4.3 (GND), U4.29 (EP), USB1.A1 (GND), USB1.A12 (GND), USB1.B1 (GND), USB1.B12 (GND), USB1.SH1 (SH), USB1.SH2 (SH), USB1.SH3 (SH), USB1.SH4 (SH), USB2.A1 (GND), USB2.A12 (GND), USB2.B1 (GND), USB2.B12 (GND), USB2.SH1 (SH), USB2.SH2 (SH), USB2.SH3 (SH), USB2.SH4 (SH)
unnamed: LED1.2 (-), R1.1
unnamed: LED2.2 (K), R12.1
unnamed: LED3.1 (+), R10.1
unnamed: LED4.1 (+), R9.1
unnamed: C6.1, C7.1, U1.10 (CRFILT)
unnamed: C8.2, C9.2, U1.23 (PLLFILT)
unnamed: R4.1, U1.24 (RBIAS)
unnamed: R5.2, U1.15 (RESET_N)
unnamed: R7.1, U1.14 (SMBCLK/CFG_SEL0)
unnamed: R6.1, U1.13 (SMBDATA/NON_REM1)
unnamed: R8.1, U1.17 (SUSP_IND/LOCAL_PWR/(NON_REM0))
unnamed: R3.1, USB1.A5 (CC1)
unnamed: R2.1, USB1.B5 (CC2)
RXD: D7.2, LED4.2 (-), TP7.1, U4.25 (RXD), USB2.B8 (SBU2)
TXD: D4.2, LED3.2 (-), TP6.1, U4.26 (TXD), USB2.A8 (SBU1)
UP_DN: D2.2, U1.19 (USBDM_UP), USB1.A7 (DN1), USB1.B7 (DN2)
UP_DP: D3.2, U1.20 (USBDP_UP), USB1.A6 (DP1), USB1.B6 (DP2)
V3V3_CP2102: C12.2, C13.2, R9.2, R10.2, TP1.1, U4.6 (VDD)
V3V3_USB2422: C3.1, C4.1, C5.1, R5.1, TP2.1, U1.1 (VDD33), U1.9 (VDD33), U1.16 (VBUS_DET), U1.18 (VDD33), U3.5 (VOUT)
VBUS: C1.1, C2.1, D1.2, LED1.1 (+), Q1.2, R11.1, TP4.1, U3.1 (VIN), U3.3 (EN), U4.7 (REGIN), U4.8 (VBUS), USB1.A4 (VBUS), USB1.A9 (VBUS), USB1.B4 (VBUS), USB1.B9 (VBUS)
VCON: LED2.1 (A), Q1.3, TP3.1, USB2.A4 (VBUS), USB2.A9 (VBUS), USB2.B4 (VBUS), USB2.B9 (VBUS)
XTAL1: C10.1, U1.22 (XTALIN/CLKIN), X1.1
XTAL2: C11.1, U1.21 (XTALOUT/(CLKIN_EN)), X1.3

Notes on the sheet:
TYPE-C HOST
USB-UART
DEVICE POWER CONTROL
3.3V LDO
USBHUB
TYPE-C DEVICE
TEST POINT

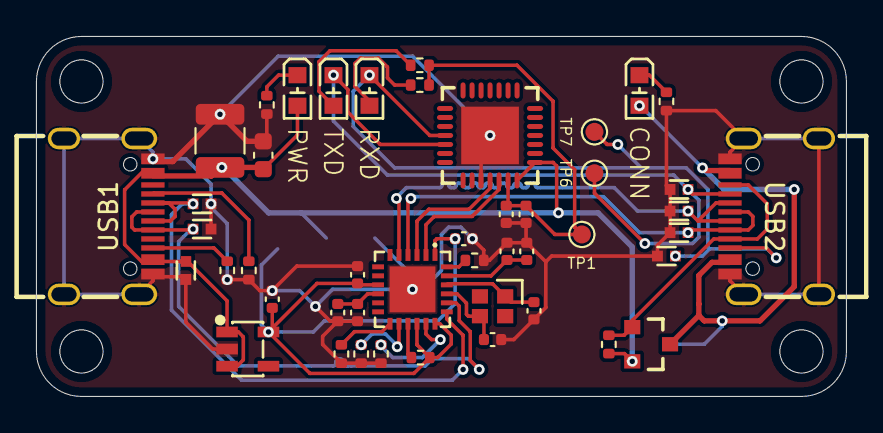
[picture p61: board LICHEE-JACK_USB_DEBUGGER.kicad_pcb from above]

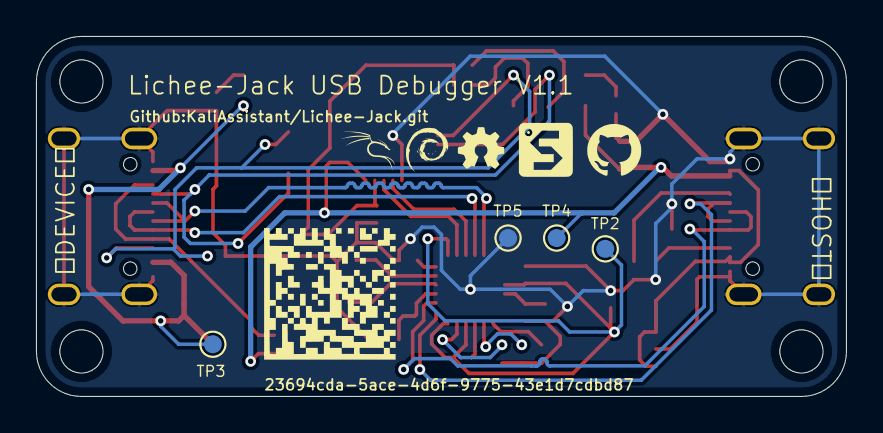
[picture p62: board LICHEE-JACK_USB_DEBUGGER.kicad_pcb from below]

Board: 2 copper layers, 45.0 x 20.0 mm, 50 parts (4 on the bottom side), 29 nets.
