KaliAssistant/Lichee-Jack-pcb/EXT_BOARD/LICHEE-JACK_EXT_BOARD/LICHEE-JACK_EXT_BOARD.kicad_pcb

## KiCad design EXT_BOARD/LICHEE-JACK_EXT_BOARD/LICHEE-JACK_EXT_BOARD.kicad_pcb (2025-12-27)

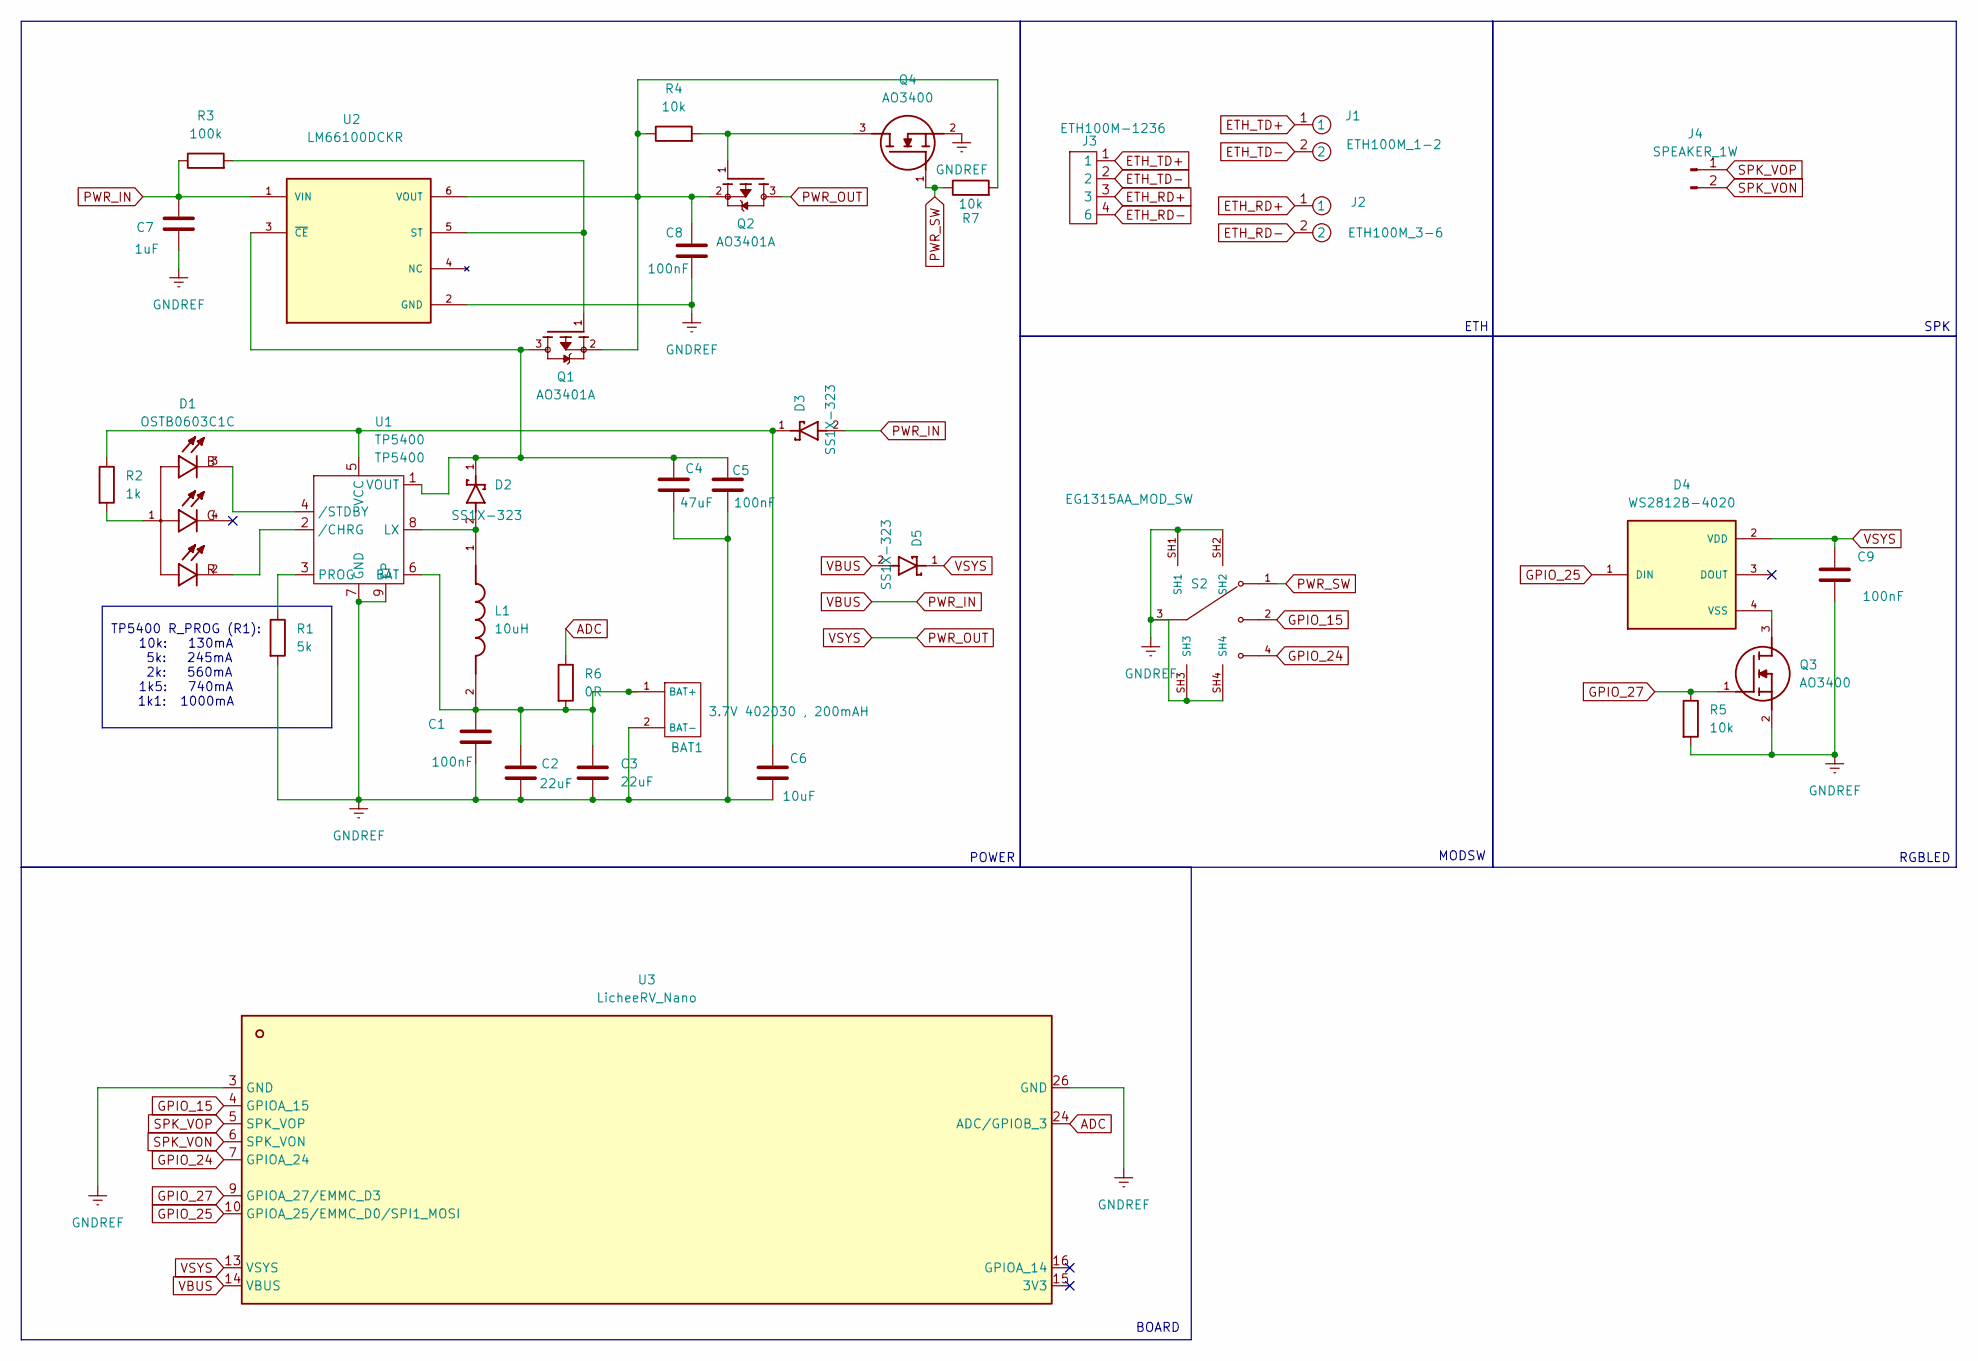
[picture p63: schematic LICHEE-JACK_EXT_BOARD.kicad_sch, Lichee-Jack EXT. Board]

Parts:
BAT1: 3.7V 402030 , 200mAH; BAT_PAD
C1, C5, C8, C9: 100nF; C_0402_1005Metric
C2, C3: 22uF; C_0805_2012Metric
C4: 47uF; C_0805_2012Metric
C6: 10uF; C_0603_1608Metric
C7: 1uF; C_0402_1005Metric
D1: OSTB0603C1C; LED_OSTB0603C1C; PARTREV A.3
D2, D3, D5: SS1X-323; DIO_PMEG4010CEJ_115; PARTREV 02
D4: WS2812B-4020; LED_WS2812B-4020; PARTREV V1.2
J1: ETH100M_1-2; ETHPAD
J2: ETH100M_3-6; ETHPAD
J3: ETH100M-1236; ETHCON
J4: SPEAKER_1W; SPK_PAD
L1: 10uH; ASPI-4030S-XXXM-T; PARTREV 03.09.13
Q1, Q2: AO3401A; SOT23-3
Q3, Q4: AO3400; SOT95P280X125-3N; MANUFACTURER_PART_NUMBER AO3400
R1: 5k; R_0402_1005Metric
R2: 1k; R_0603_1608Metric
R3: 100k; R_0402_1005Metric
R4, R5, R7: 10k; R_0402_1005Metric
R6: 0R; R_0402_1005Metric
S2: EG1315AA_MOD_SW; SW_EG1315AA; PARTREV 7.13.2018
U1: TP5400; SOIC-8-1EP_3.9x4.9mm_P1.27mm_EP2.29x3mm
U2: LM66100DCKR; SOT65P210X110-6N; PARTREV Rev. A
U3: LicheeRV_Nano; LicheeRV_Nano_MD

Connections:
ADC: R6.1, U3.24 (ADC/GPIOB_3)
ETH_RD+: J2.1, J3.3
ETH_RD-: J2.2, J3.4 (6)
ETH_TD+: J1.1, J3.1
ETH_TD-: J1.2, J3.2
GNDREF: BAT1.2 (BAT-), C1.2, C2.2, C3.2, C4.2, C5.2, C6.2, C7.2, C8.2, C9.2, Q3.2, Q4.2, R1.2, R5.2, S2.3, S2.SH1, S2.SH2, S2.SH3, S2.SH4, U1.7 (GND), U1.9 (EP), U2.2 (GND), U3.3 (GND), U3.26 (GND)
GPIO_15: S2.2, U3.4 (GPIOA_15)
GPIO_24: S2.4, U3.7 (GPIOA_24)
GPIO_25: D4.1 (DIN), U3.10 (GPIOA_25/EMMC_D0/SPI1_MOSI)
GPIO_27: Q3.1, R5.1, U3.9 (GPIOA_27/EMMC_D3)
unnamed: BAT1.1 (BAT+), C1.1, C2.1, C3.1, L1.2, R6.2, U1.6 (BAT)
unnamed: D1.1, R2.2
unnamed: D4.4 (VSS), Q3.3
unnamed: Q2.1, Q4.3, R4.2
unnamed: D2.2, L1.1, U1.8 (LX)
unnamed: R1.1, U1.3 (PROG)
unnamed: C6.1, D3.1, R2.1, U1.5 (VCC)
unnamed: C4.1, C5.1, D2.1, Q1.3, U1.1 (VOUT), U2.3 (~CE)
unnamed: D1.2, U1.2 (/CHRG)
unnamed: D1.3, U1.4 (/STDBY)
unnamed: Q1.1, R3.2, U2.5 (ST)
unnamed: C8.1, Q1.2, Q2.2, R4.1, R7.2, U2.6 (VOUT)
PWR_IN: C7.1, D3.2, D5.2, R3.1, U2.1 (VIN), U3.14 (VBUS)
PWR_OUT: C9.1, D4.2 (VDD), D5.1, Q2.3, U3.13 (VSYS)
PWR_SW: Q4.1, R7.1, S2.1
SPK_VON: J4.2, U3.6 (SPK_VON)
SPK_VOP: J4.1, U3.5 (SPK_VOP)

Notes on the sheet:
ETH
BOARD
RGBLED
MODSW
SPK
TP5400 R_PROG (R1): 10k: 130mA 5k: 245mA 2k: 560mA 1k5: 740mA 1k1: 1000mA
POWER

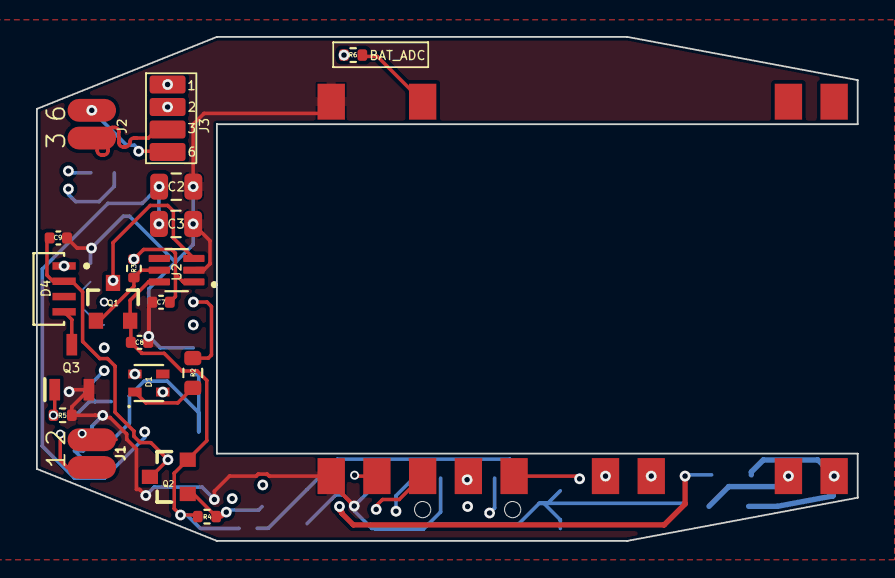
[picture p64: board LICHEE-JACK_EXT_BOARD.kicad_pcb from above]

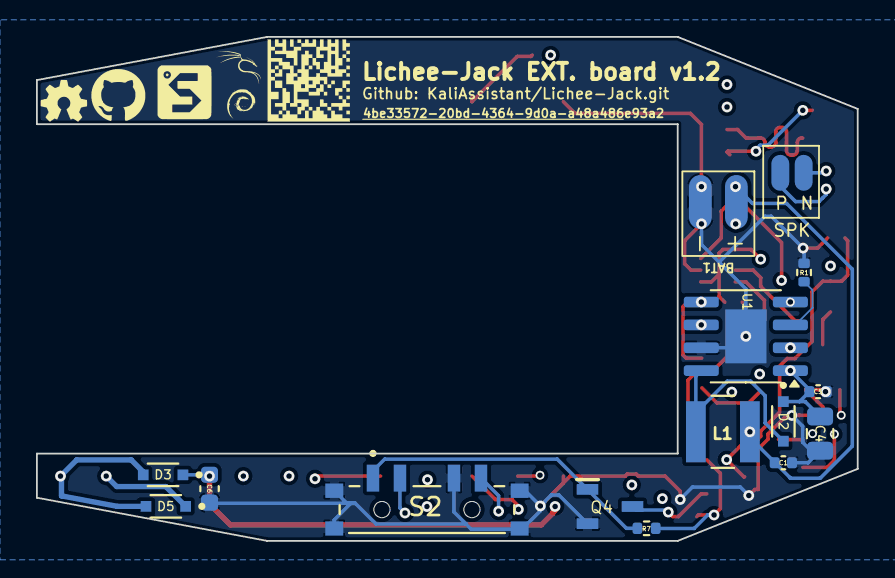
[picture p65: board LICHEE-JACK_EXT_BOARD.kicad_pcb from below]

Board: 4 copper layers, 45.6 x 28.0 mm, 35 parts (15 on the bottom side), 27 nets.
