KaliAssistant/Lichee-Jack-pcb/EXT_BOARD/LICHEE-JACK_EXT_BOARD_FPC/LICHEE-JACK_EXT_BOARD_FPC.kicad_pcb

## KiCad design EXT_BOARD/LICHEE-JACK_EXT_BOARD_FPC/LICHEE-JACK_EXT_BOARD_FPC.kicad_pcb (2025-12-26)

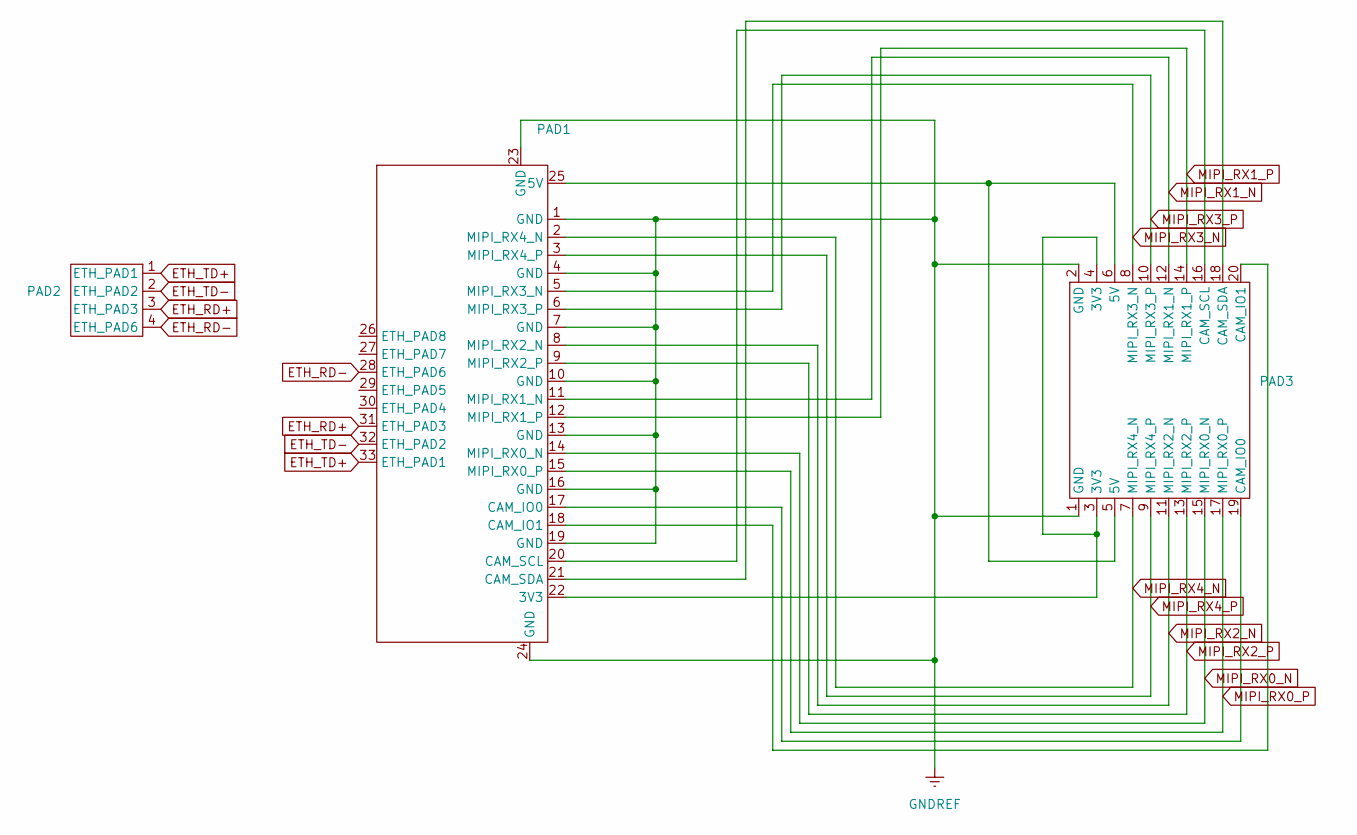
[picture p66: schematic LICHEE-JACK_EXT_BOARD_FPC.kicad_sch, Lichee-Jack EXT. board FPC]

Parts:
PAD1: _TO_STACK_BOARD_
PAD2: ETH_PAD
PAD3: HEADER_PAD

Connections:
ETH_RD+: PAD1.31 (ETH_PAD3), PAD2.3 (ETH_PAD3)
ETH_RD-: PAD1.28 (ETH_PAD6), PAD2.4 (ETH_PAD6)
ETH_TD+: PAD1.33 (ETH_PAD1), PAD2.1 (ETH_PAD1)
ETH_TD-: PAD1.32 (ETH_PAD2), PAD2.2 (ETH_PAD2)
GNDREF: PAD1.1 (GND), PAD1.4 (GND), PAD1.7 (GND), PAD1.10 (GND), PAD1.13 (GND), PAD1.16 (GND), PAD1.19 (GND), PAD1.23 (GND), PAD1.24 (GND), PAD3.1 (GND), PAD3.2 (GND)
MIPI_RX0_N: PAD1.14 (MIPI_RX0_N), PAD3.15 (MIPI_RX0_N)
MIPI_RX0_P: PAD1.15 (MIPI_RX0_P), PAD3.17 (MIPI_RX0_P)
MIPI_RX1_N: PAD1.11 (MIPI_RX1_N), PAD3.12 (MIPI_RX1_N)
MIPI_RX1_P: PAD1.12 (MIPI_RX1_P), PAD3.14 (MIPI_RX1_P)
MIPI_RX2_N: PAD1.8 (MIPI_RX2_N), PAD3.11 (MIPI_RX2_N)
MIPI_RX2_P: PAD1.9 (MIPI_RX2_P), PAD3.13 (MIPI_RX2_P)
MIPI_RX3_N: PAD1.5 (MIPI_RX3_N), PAD3.8 (MIPI_RX3_N)
MIPI_RX3_P: PAD1.6 (MIPI_RX3_P), PAD3.10 (MIPI_RX3_P)
MIPI_RX4_N: PAD1.2 (MIPI_RX4_N), PAD3.7 (MIPI_RX4_N)
MIPI_RX4_P: PAD1.3 (MIPI_RX4_P), PAD3.9 (MIPI_RX4_P)
unnamed: PAD1.22 (3V3), PAD3.3 (3V3), PAD3.4 (3V3)
unnamed: PAD1.25 (5V), PAD3.5 (5V), PAD3.6 (5V)
unnamed: PAD1.17 (CAM_IO0), PAD3.19 (CAM_IO0)
unnamed: PAD1.18 (CAM_IO1), PAD3.20 (CAM_IO1)
unnamed: PAD1.20 (CAM_SCL), PAD3.16 (CAM_SCL)
unnamed: PAD1.21 (CAM_SDA), PAD3.18 (CAM_SDA)

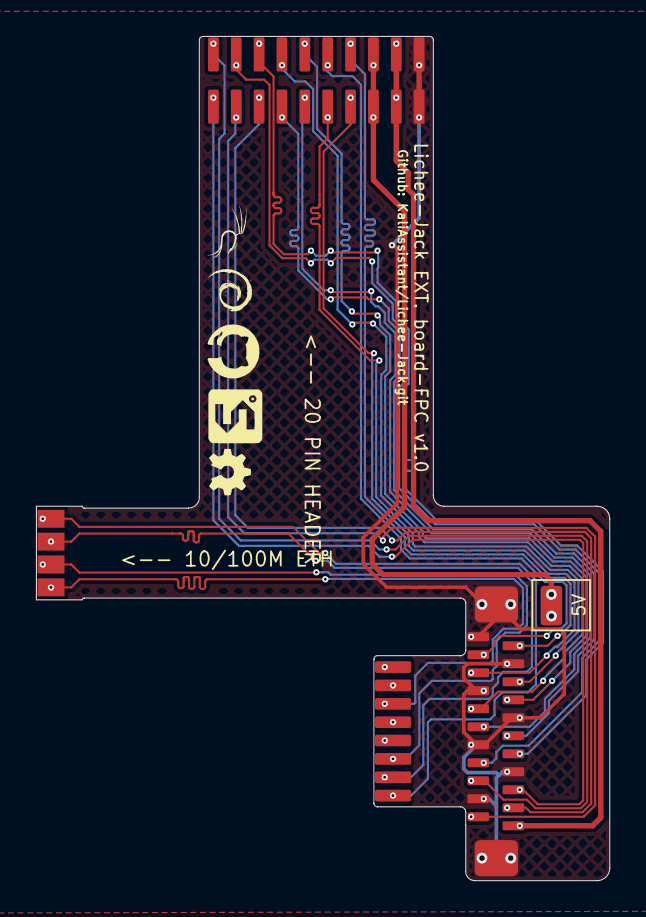
[picture p67: board LICHEE-JACK_EXT_BOARD_FPC.kicad_pcb from above]

Board: 2 copper layers, 31.9 x 46.9 mm, 3 parts (0 on the bottom side), 21 nets.
