KaliAssistant/Lichee-Jack-pcb/(commit log)

2025-09-17 GPIOA16 -> GPIOA15, PWRIN-PWRVBUS ADD DIODE
    [LICHEE-JACK_EXT_BOARD.kicad_pcb]
2025-12-27 update some files
    [LICHEE-JACK_EXT_BOARD.kicad_pcb, LICHEE-JACK_HEADER_BOARD.kicad_pcb]
2026-01-11 New PCB Design: Lichee-Jack USB Debugger
    [C1210_L3.2-W2.5-H2.5.step, CRYSTAL-SMD_4P-L2.0-W1.6-BL.step, LED0603-RD_GREEN.step, LED0603_Inf.step, LICHEE-JACK_USB_DEBUGGER.kicad_pcb, LICHEE-JACK_USB_DEBUGGER.kicad_sch, QFN-24_L4.0-W4.0-H0.9-P0.50.step, SOT-23-5_L3.0-W1.6-P0.95-LS2.8-BR.step]
2026-01-12 replace some obj
    [LED0603-RD-1.step, LICHEE-JACK_USB_DEBUGGER.kicad_pcb, LICHEE-JACK_USB_DEBUGGER.kicad_sch]
2026-01-13 update some info
    [LICHEE-JACK_USB_DEBUGGER.kicad_pcb, LICHEE-JACK_USB_DEBUGGER.kicad_sch]
2026-01-13 rename LED5
    [LICHEE-JACK_USB_DEBUGGER.kicad_pcb, LICHEE-JACK_USB_DEBUGGER.kicad_sch]
2026-01-14 rename LED3
    [LICHEE-JACK_USB_DEBUGGER.kicad_sch]
2026-01-14 case problem, delete dup
    [TLV76733DRVR.STEP]
2026-01-17 fix TX/RX LED, USB DEBUGGER v1.1
    [LICHEE-JACK_USB_DEBUGGER.kicad_pcb, LICHEE-JACK_USB_DEBUGGER.kicad_sch]
