KaliAssistant/Lichee-Jack-pcb/(notices)

Notices in the files:
3dmodules/FTS-110-04-F-D.step:
author */ ('License CC BY-ND 4.0'),
